kodediy/kode-dot/1-ECAD/cyberman/3-Assets/2-Images/5033981892.jpg

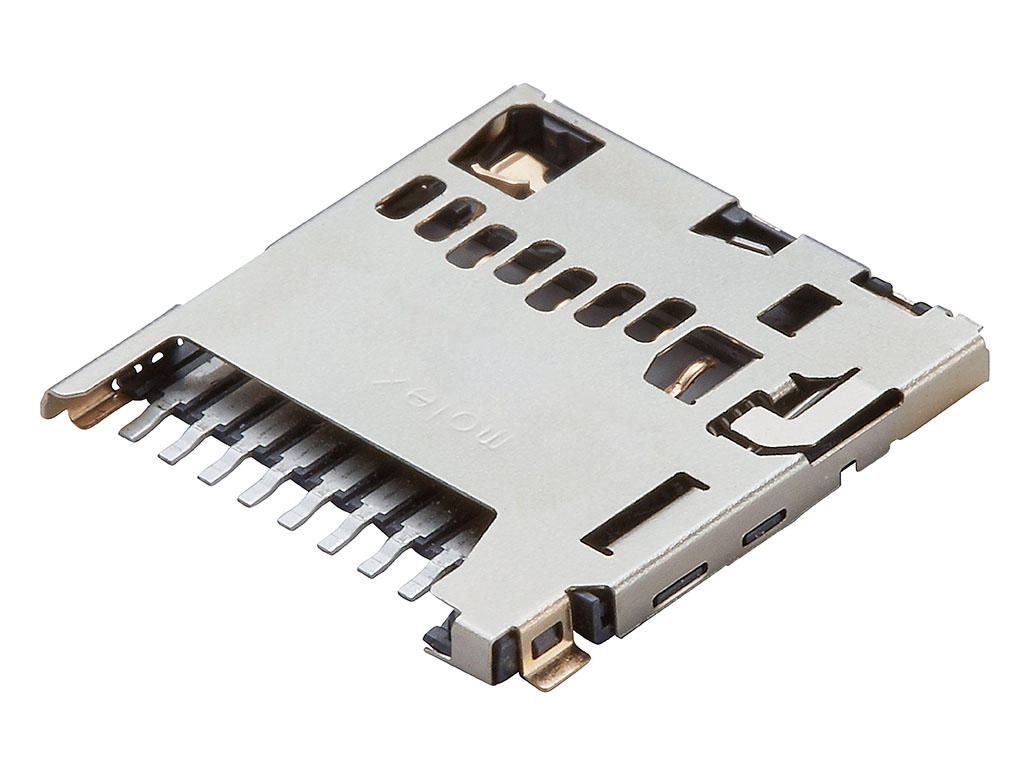
1-ECAD/cyberman/3-Assets/2-Images/5033981892.jpg
