kodediy/kode-dot/1-ECAD/cyberman/3-Assets/2-Images/532610271.jpeg

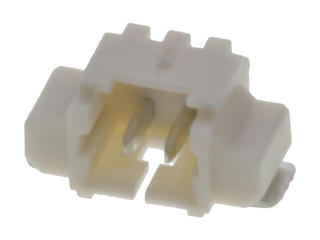
1-ECAD/cyberman/3-Assets/2-Images/532610271.jpeg
