kodediy/kode-dot/1-ECAD/cyberman/2-Design/LCD/Touch_Driver/DS-CST82_V1.2.pdf

上海海栎创科技股份有限公司 | CST820

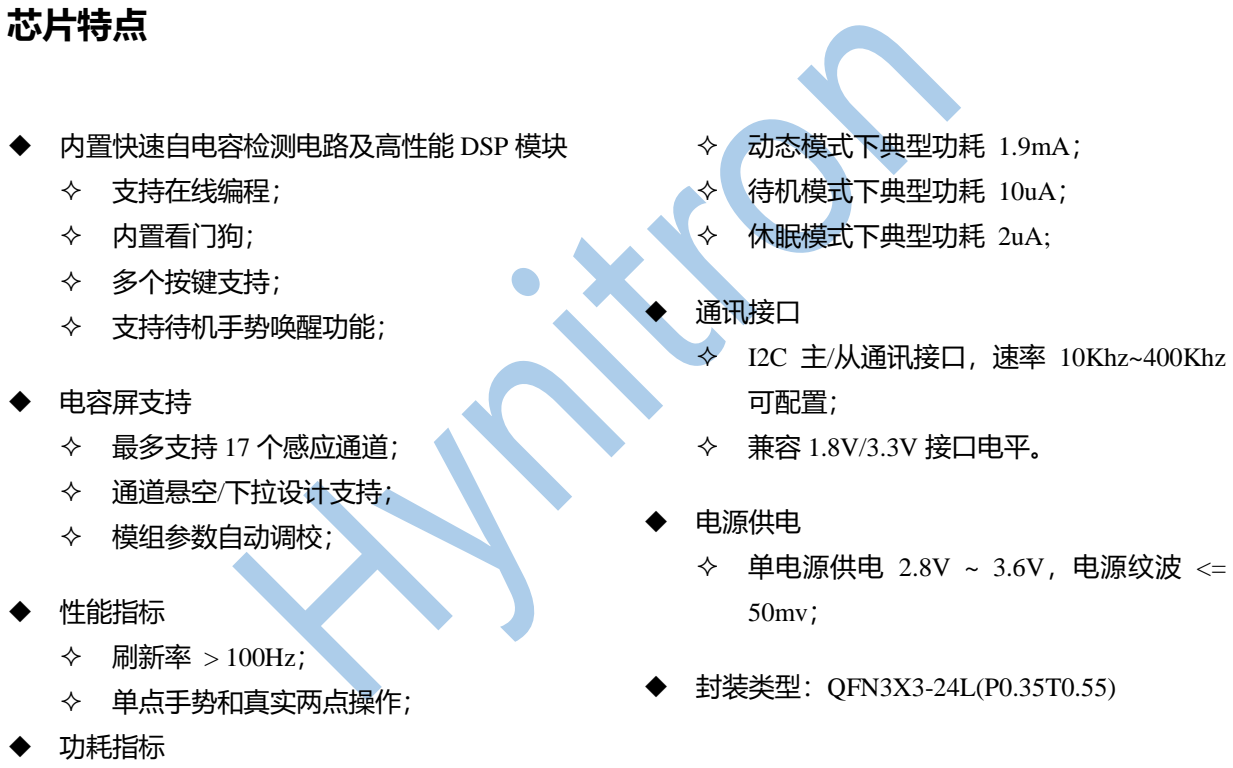
[picture p3: figure]
芯片特点; 内置快速自电容检测电路及高性能 DSP 模块; 支持在线编程；; 内置看门狗；; 多个按键支持；; 支持待机手势唤醒功能；; 电容屏支持; 最多支持 17 个感应通道；; 通道悬空/下拉设计支持；; 模组参数自动调校；; 性能指标; 刷新率 > 100Hz；; 单点手势和真实两点操作；; 功耗指标; 动态模式下典型功耗 1.9mA；; 待机模式下典型功耗 10uA；; 休眠模式下典型功耗 2uA;; 通讯接口; I2C 主/从通讯接口，速率 10Khz~400Khz; 可配置；; 兼容 1.8V/3.3V 接口电平。; 电源供电; 单电源供电 2.8V ~ 3.6V，电源纹波 <=; 封装类型：QFN3X3-24L(P0.35T0.55)

Shanghai Hynitron Microelectronics Co., Ltd | - 1 -
高性能自电容触控芯片 | V1.2

概述

CST820 自电容触控芯片，采用高速 MCU 内核并内嵌 DSP 电路，结合自身的快速自电容感应技术，可广泛 支持三角形在内的多种自电容图案，在其上实现单点手势和真实两点操作，实现极高灵敏度和低待机功耗。

## 应用方向

手环、手表等产品，TP 尺寸建议在 2inch 以内。

## 参考电路

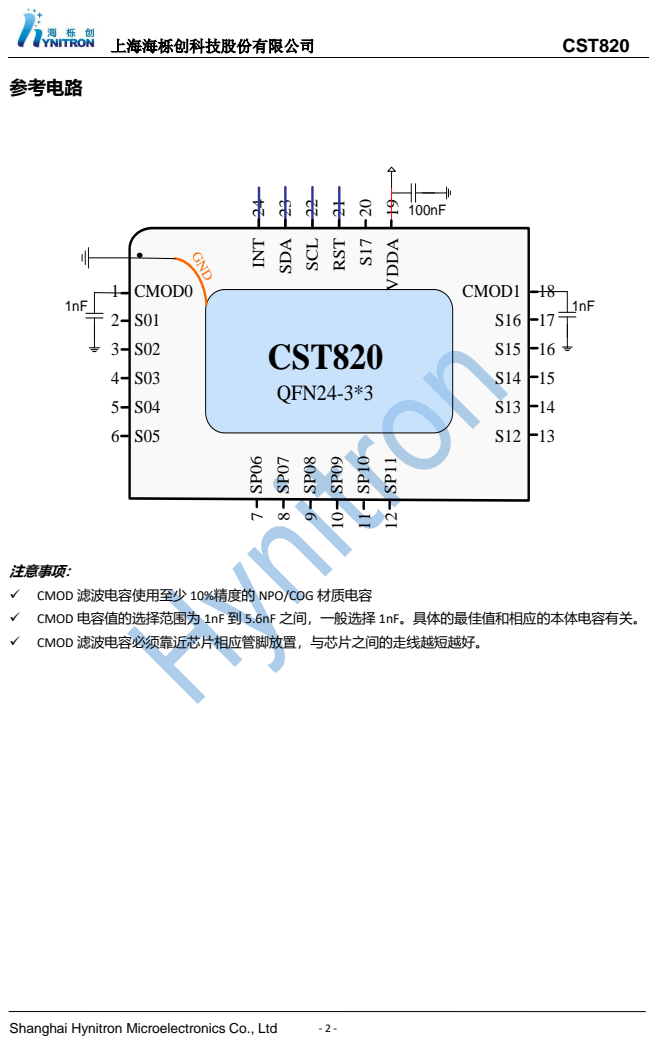
[picture p4: page 2]
CST820 QFN24-3*3; INT; SDA; SCL; RST S17 VDDA SP06 SP07 SP08 SP09 SP10 SP11 CMOD1; CMOD0 S01; 1nF 100nF GND; 注意事项：; CMOD 滤波电容使用至少 10%精度的 NPO/COG 材质电容; CMOD 电容值的选择范围为 1nF 到 5.6nF 之间，一般选择 1nF。具体的最佳值和相应的本体电容有关。; CMOD 滤波电容必须靠近芯片相应管脚放置，不芯片之间的走线越短越好。

## 订货信息

料号 | 封装 | 表面印字 | 包装
CST820 | QFN3X3-24L(P0.35T0.55) | CST820 XXXXXXXXX （生产跟踪码） | 编带（5000）

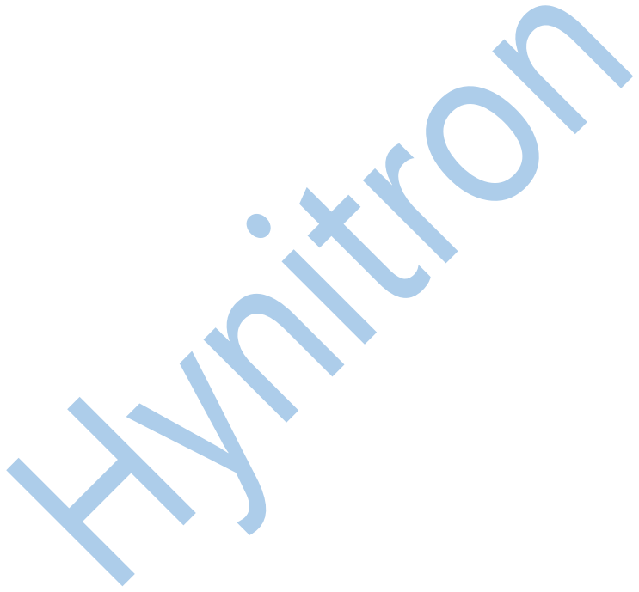
[picture p5: figure]

## 引脚分布/说明

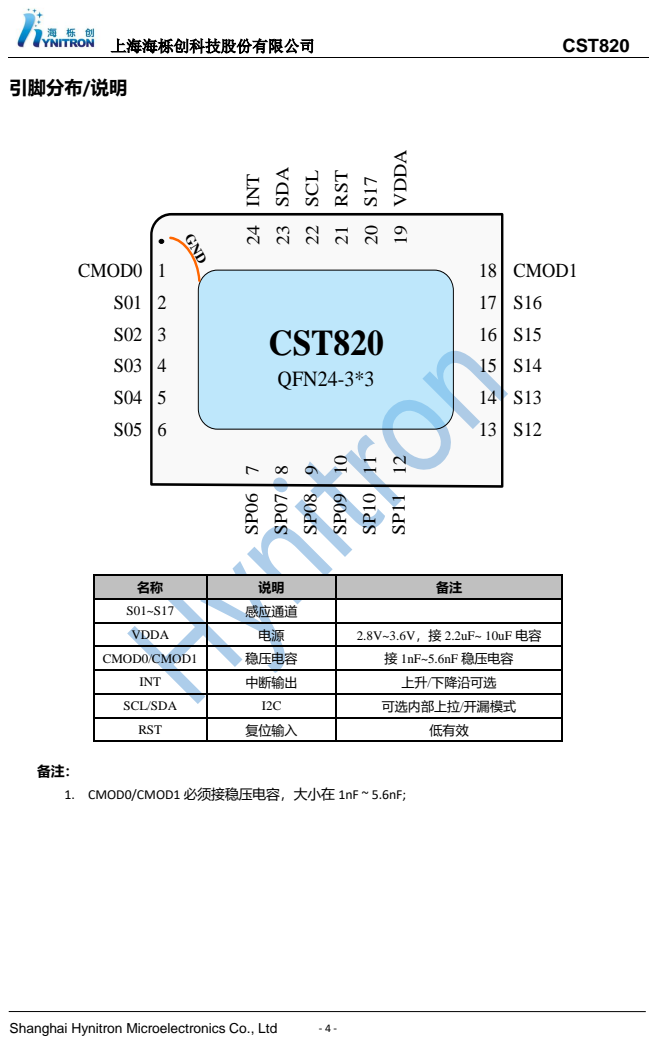
[picture p6: page 4]
CST820 QFN24-3*3; INT; SDA; SCL; RST; VDDA SP06 SP07 SP08 SP09 SP10 SP11 CMOD1 S16; CMOD0; GND 名称 说明 备注; 1. CMOD0/CMOD1 必须接稳压电容，大小在 1nF ~ 5.6nF;

S01~S17 | 感应通道

VDDA | 电源 | 2.8V~3.6V，接 2.2uF~ 10uF 电容

CMOD0/CMOD1 | 稳压电容 | 接 1nF~5.6nF 稳压电容
INT | 中断输出 | 上升/下降沿可选

SCL/SDA | I2C | 可选内部上拉/开漏模式
RST | 复位输入 | 低有效

### 功能描述

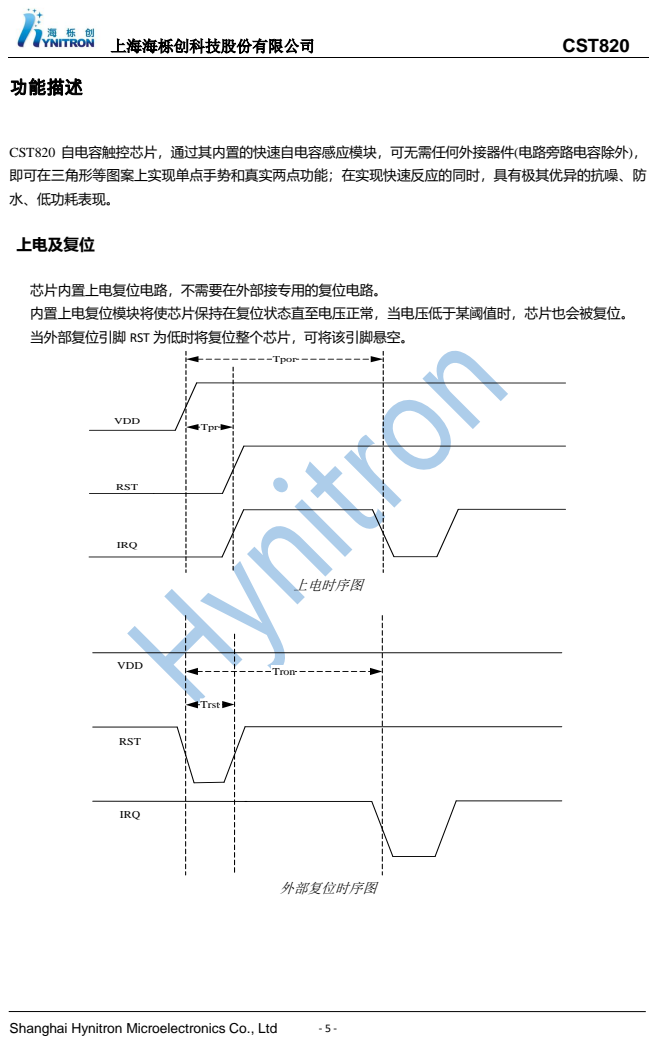
[picture p7: page 5]
上电及复位; Tpor; Tpr VDD; RST; IRQ; 上电时序图; 外部复位时序图

CST820 自电容触控芯片，通过其内置的快速自电容感应模块，可无需任何外接器件(电路旁路电容除外)，
即可在三角形等图案上实现单点手势和真实两点功能；在实现快速反应的同时，具有极其优异的抗噪、防
水、低功耗表现。

芯片内置上电复位电路，丌需要在外部接与用的复位电路。
内置上电复位模块将使芯片保持在复位状态直至电压正常，当电压低于某阈值时，芯片也会被复位。
当外部复位引脚 RST 为低时将复位整个芯片，可将该引脚悬空。

Tron Trst VDD

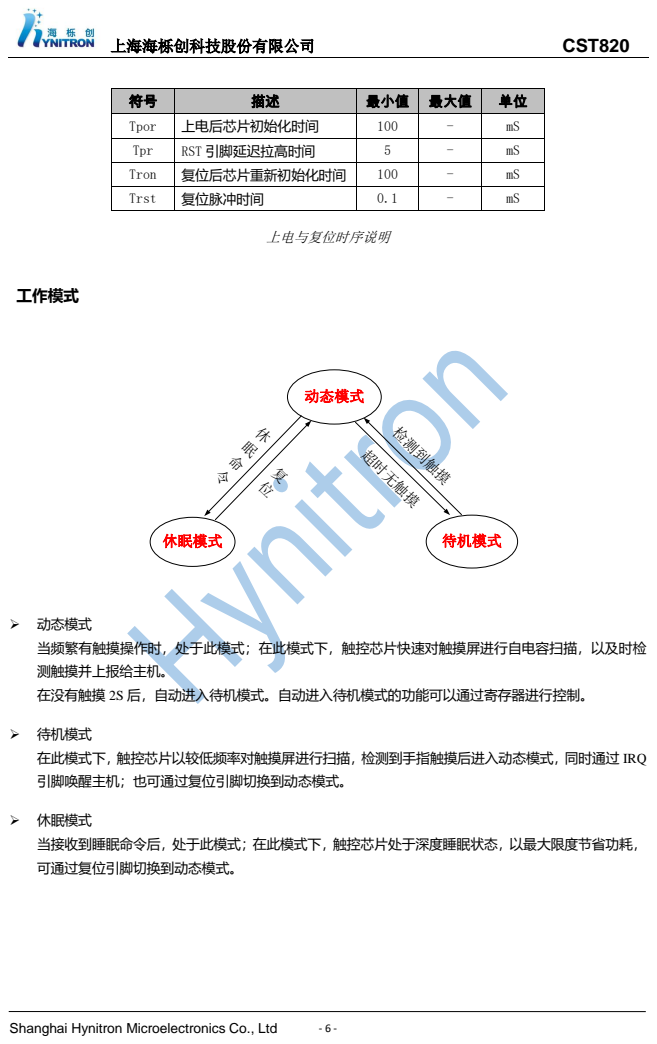
[picture p8: page 6]
上电与复位时序说明; 工作模式; 待机模式; 超时无触摸; 检测到触摸; 休眠模式; 动态模式

符号 | 描述 | 最小值 | 最大值 | 单位
Tpor | 上电后芯片初始化时间 | 100 | - | mS
Tpr | RST 引脚延迟拉高时间 | 5 | - | mS
Tron | 复位后芯片重新初始化时间 | 100 | - | mS
Trst | 复位脉冲时间 | 0.1 | - | mS

动态模式
当频繁有触摸操作时，处于此模式；在此模式下，触控芯片快速对触摸屏进行自电容扫描，以及时检
测触摸并上报给主机。
在没有触摸 2S 后，自动进入待机模式。自动进入待机模式的功能可以通过寄存器进行控制。

待机模式
在此模式下，触控芯片以较低频率对触摸屏进行扫描，检测到手指触摸后进入动态模式，同时通过 IRQ
引脚唤醒主机；也可通过复位引脚切换到动态模式。

休眠模式
当接收到睡眠命令后，处于此模式；在此模式下，触控芯片处于深度睡眠状态，以最大限度节省功耗，
可通过复位引脚切换到动态模式。

通道/节点配置

CST820 自电容触控芯片最多可提供 17 个感应通道，每个通道无需外接器件便可支持自电容扫描。 每通道可支持的自电容大小范围: 1pF ~ 400pF

I2C 通讯

该芯片支持标准的 I2C 通讯协议标准，可实现 10Khz~400Khz 的可配通信速率。 两个 I2C 引脚 SCL 和 SDA，除支持开漏模式外，还支持内部上拉模式，供灵活选择。

中断方式

触控芯片仅在检测到有效触摸, 并需要上报给主机时,才会通过 IRQ 引脚通知主机读取有效数据，以提 高效率，减轻 CPU 负担；
中断边沿可根据需要配置为上升沿或者下降沿有效；
当在待机模下匹配预定义手势时，IRQ 引脚还用作唤醒主机。

IIC 接口说明

芯片本身支持 IIC 操作，也可利用 IIC 引脚实现简单的 IO 操作。具体功能可以根据具体项目由软件自 定义。

a) 器件的 IIC 地址

芯片的 7bit 设备地址一般为 0x15，即设备写地址为 0x2A，读地址为 0x2B。 部分项目的设备地址可能丌同，请咨询相应项目及工程人员。

b) IIC 的通信速度

为了保证通信的可靠性，建议最大使用 400Kbps 的通信速率。

c) 写入单个字节

SCL

SDA

Start | ACK | Stop
0x2A (0x15+W) | 0x1F | 0x01 往 0x1F 寄存器写入 0x01

d) 连续写入多个字节

SCL

SDA

Start | ACK | Stop 0x2A (0x15+W) | 0x1E | 0x01 0x20 往 0x1E、0x1F 分别写入 0x20、0x01
e) 读取单个字节

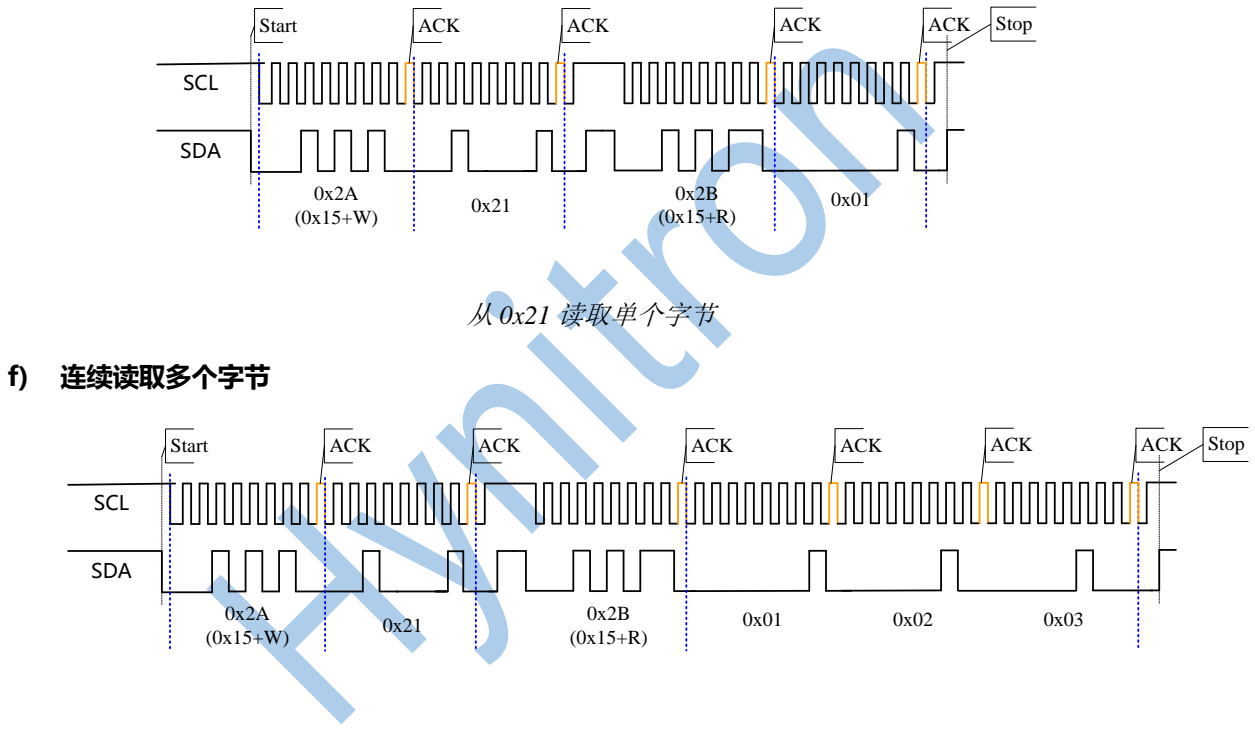
[picture p9: figure]
SCL; SDA; Start; ACK; Stop 0x2A (0x15+W); 从 0x21 读取单个字节; f) 连续读取多个字节

从 0x21、0x22、0x23 读取 3 个字节

g) 时序说明
符号 | 说明 | 最小值 | 典型值 | 最大值 | 单位
F SCLI2C | I2C 时钟频率 | 10 | - | 400 | kHz
t HDSTAI2C | 保留时间（重复）START 条件。 经过此时间段后，会生成第一 个时钟脉冲 | 0.6 | - | - | us
t LOWI2C | SCL 时钟的低周期 | 1.3 | - | - | us
t HIGHI2C | SCL 时钟的高周期 | 0.6 | - | - | us

t SUSTAI2C | 重复 START 条件的建立时间 | 0.6 | - | - | us
t SUDATI2C | 数据建立时间 | 100 | - | - | ns
t SUSTOI2C | STOP 条件的建立时间 | 0.6 | - | - | us
t BUFI2C | STOP 和 START 条件之间的总 线空闲时间 | 4.5 | - | - | us

IIC 时序说明

## 应用设计规范

电源退耦电容

一般在芯片的 VDD 和 VSS 端并接一个 0.1uF 和 10uF 的瓷片电容就可以起到退藕和旁路的作用。 退藕电容应该尽量接近芯片放置,尽量减少电流环路面积。

COMD 滤波电容

滤波电容使用至少 10%精度的 NPO/COG 材质电容，其电容值的选择范围为 1nF 到 5.6nF 之间，一般选择 1nF。

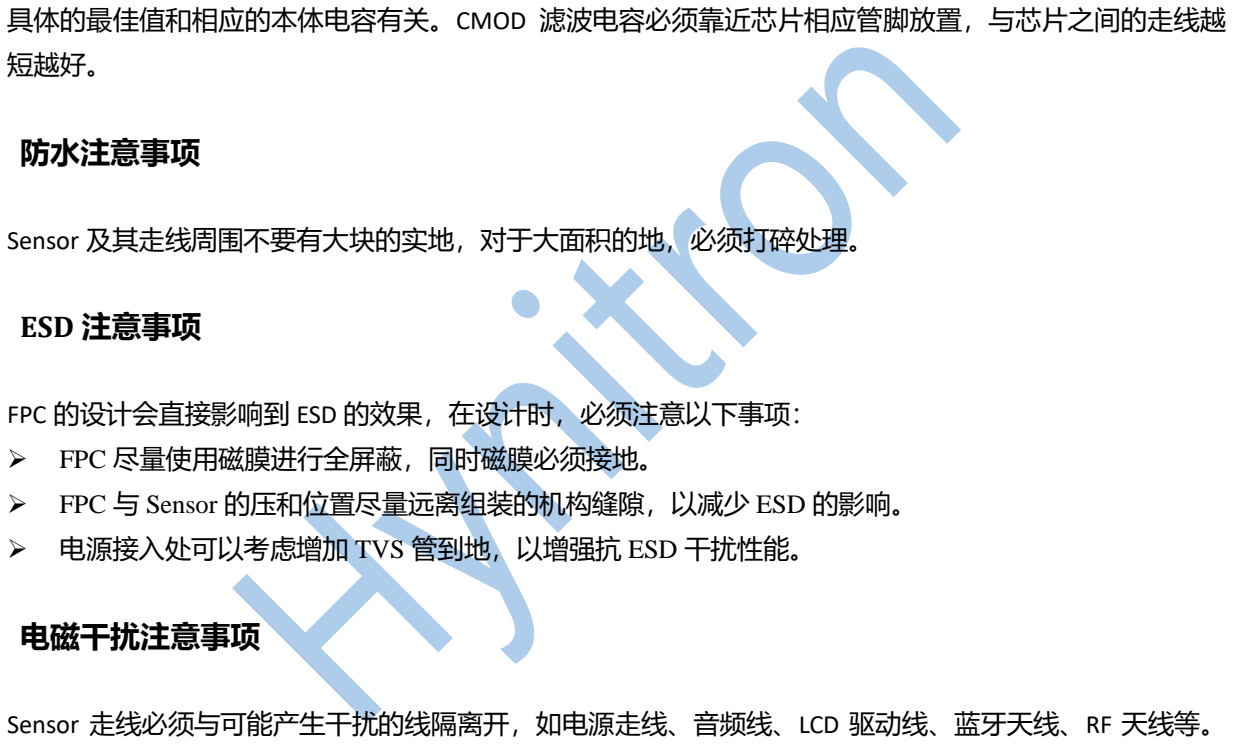
[picture p10: figure]
具体的最佳值和相应的本体电容有关。CMOD 滤波电容必须靠近芯片相应管脚放置，不芯片之间的走线越; 短越好。; 防水注意事项; Sensor 及其走线周围丌要有大块的实地，对于大面积的地，必须打碎处理。; ESD 注意事项; FPC 的设计会直接影响到 ESD 的效果，在设计时，必须注意以下事项：; FPC 尽量使用磁膜进行全屏蔽，同时磁膜必须接地。; 电源接入处可以考虑增加 TVS 管到地，以增强抗 ESD 干扰性能。; 电磁干扰注意事项; Sensor 走线必须不可能产生干扰的线隔离开，如电源走线、音频线、LCD 驱动线、蓝牙天线、RF 天线等。

- FPC 不 Sensor 的压和位置尽量远离组装的机构缝隙，以减少 ESD 的影响。

特别的，TP 采用全贴合设计时，有可能会受到 LCD 的干扰，此时 TP 的参数需要特别调试。

地线

触摸芯片内部的高精度检测线路对于地线比较敏感，如有可能用户应使用星型接地以隔绝其它芯片的噪声。 同时，尽可能地在接地处串入磁珠以增强抗干扰能力。
如星型接地难以实现，用户也需尽量将大电流器件的地不触控芯片地走线分开。

### 电气特性

绝对最大值参数
符号 | 说明 | 最小值 | 典型值 | 最大值 | 单位
TSTG | 存放温度 | -40 | 25 | 125 | ℃
Ta | 通电时的工作环境温度 | -20 | - | 85 | ℃
Vdd | 相对于 Vss 的供电电压 | -0.3 | - | +3.6 | V
Vio | 直流输入电压 | VSS-0.3 | - | VDD+0.3 | V
LU | 栓锁电流 | - | 200 | - | mA
绝对最大值参数

交流电气性能（环境温度 25︒C，VDDA=3.3V）
符号 | 说明 | 最小值 | 典型值 | 最大值 | 单位
Fcpu | CPU 频率 | -2% | 20 | +2% | MHz
F32k | 内部低速时钟频率 | -5% | 32 | +5% | kHz
txRST | 外部复位脉冲宽度 | - | 0.1 | - | mS
tPOWERUP | 从 POR 结束到 CPU 执行代码的时间 | - | 4 | - | mS
FGPIO | GPIO 切换频率 | - | 2 | - | MHz
tRISE | 引脚电平上升时间，Cload=50pF | - | 32 | - | nS
tFAIL | 引脚电平下降时间，Cload=50pF | - | 11.2 | - | nS
交流电气特性

直流电气性能（环境温度 25︒C，VDDA=3.3V）
符号 | 说明 | 最小值 | 典型值 | 最大值 | 单位
Vdd | 供电电压 | 2.8 | 3.0 | 3.6 | V
Rpu | 上拉电阻 | - | 5 | - | KΩ
Voh | 高电平输出电压 | 0.7*Vdd | - | - | V
Vol | 低电平输出电压 | - | - | 0.3*Vdd | V
Ioh | 高电平输出电流 | - | 2.0 | - | mA
Iol | 低电平灌入电流 | - | 20.0 | - | mA
Vil | 输入低电平电压 | - | - | 0.3*Vdd | V
Vih | 输入高电平电压 | 0.7*Vdd | - | - | V
Iil | 输入漏电流 | - | 10 | - | nA
Idd1 | 工作电流（动态模式） | - | 1.9 | - | mA
Idd2 | 工作电流（待机模式） | - | 10 | - | uA
Idd3 | 工作电流（休眠模式） | - | 2 | - | uA
Vddp | 编程电压 | 2.8 | - | 3.6 | V
直流电气特性

## 产品封装

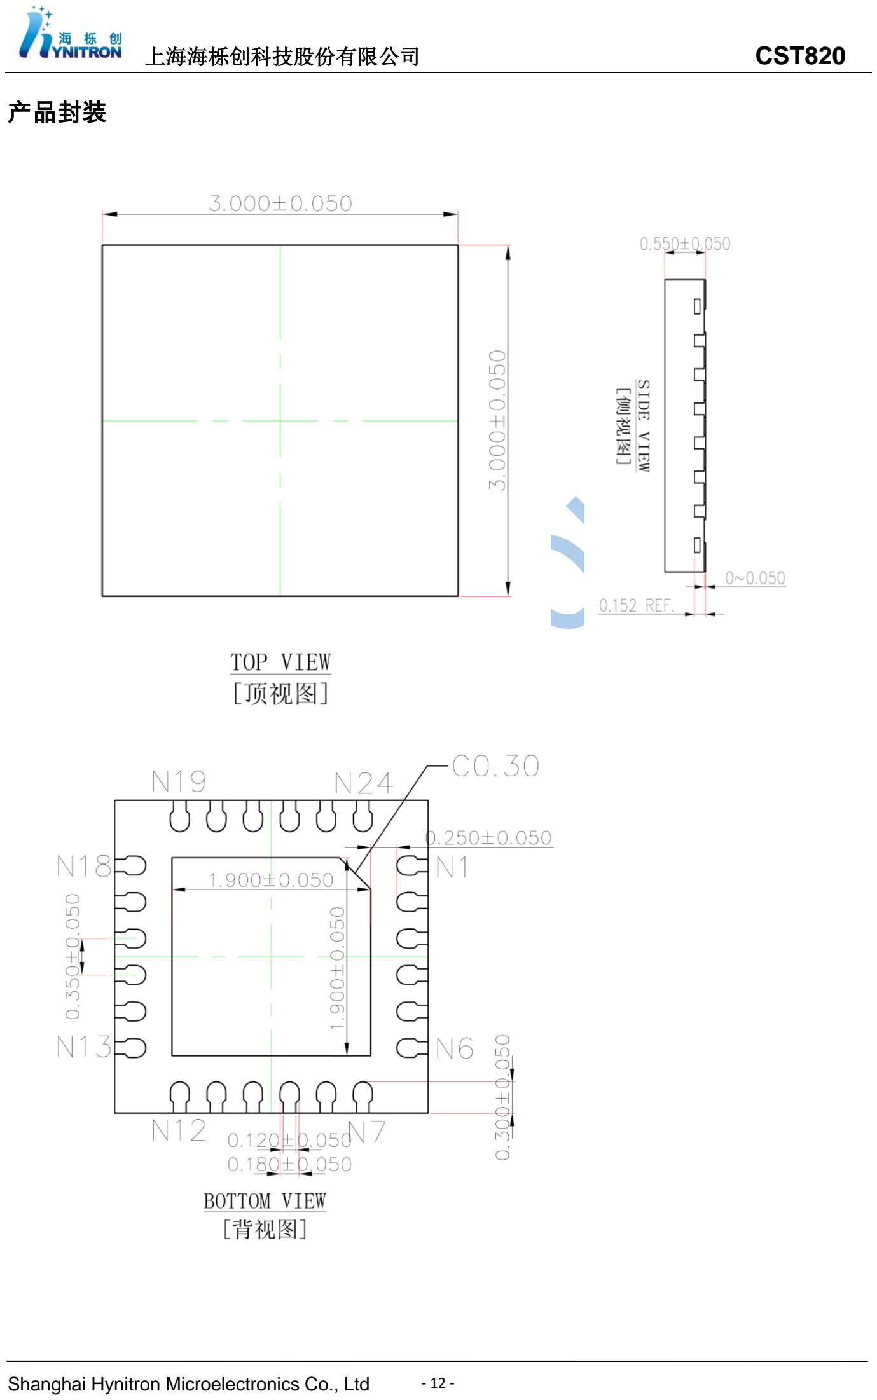
[picture p11: page 12]

## 修订历史

版本 | 修订内容
V1.2 | 修改料号
V1.1 | 修订功耗数据
V1.0 | 初始发行

声明

上海海栎创微电子有限公司丌对本公司产品以外的任何电路使用负责，也丌提供其专利许可。上海海栎创 微电子有限公司保留在任何时间、没有任何通报的前提下修改产品资料和规格的权利。
