kodediy/kode-dot/1-ECAD/cyberman/3-Assets/2-Images/ClockCap.png

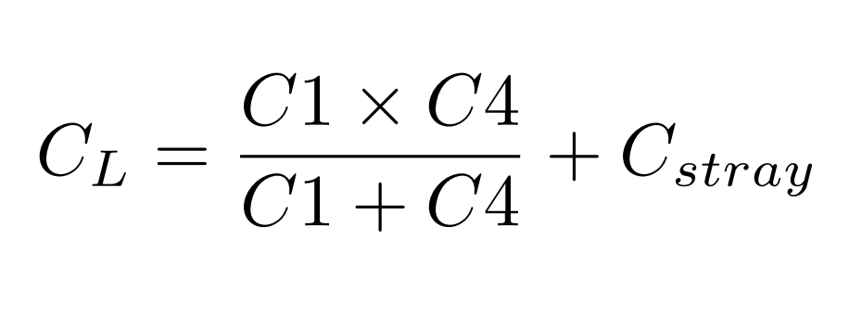
1-ECAD/cyberman/3-Assets/2-Images/ClockCap.png
