kodediy/kode-dot/1-ECAD/cyberman/3-Assets/2-Images/default-configuration-strapping-pins.png

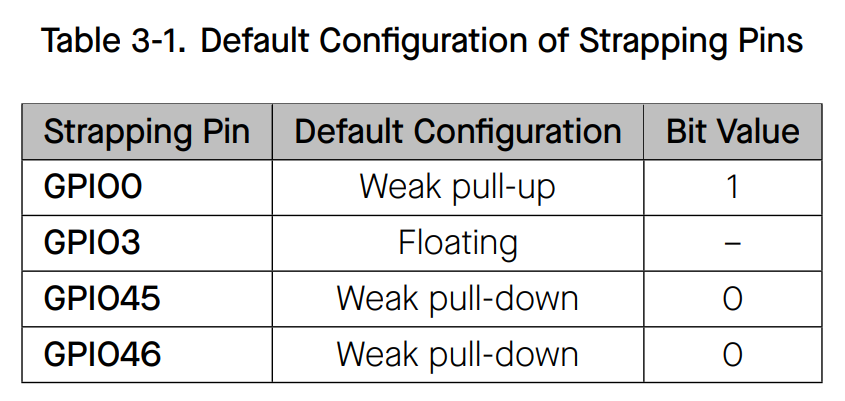
1-ECAD/cyberman/3-Assets/2-Images/default-configuration-strapping-pins.png
