kodediy/kode-dot/1-ECAD/cyberman/3-Assets/2-Images/pin-to-pin-Map.png

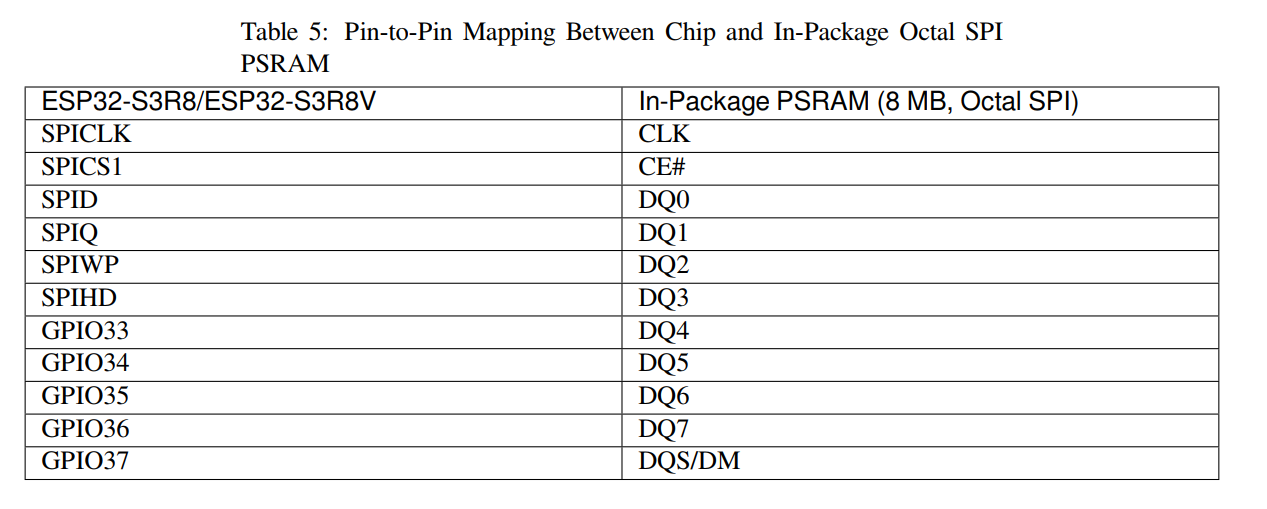
1-ECAD/cyberman/3-Assets/2-Images/pin-to-pin-Map.png
