kodediy/kode-dot/1-ECAD/cyberman/3-Assets/2-Images/Power-up&Reset_Timing.png

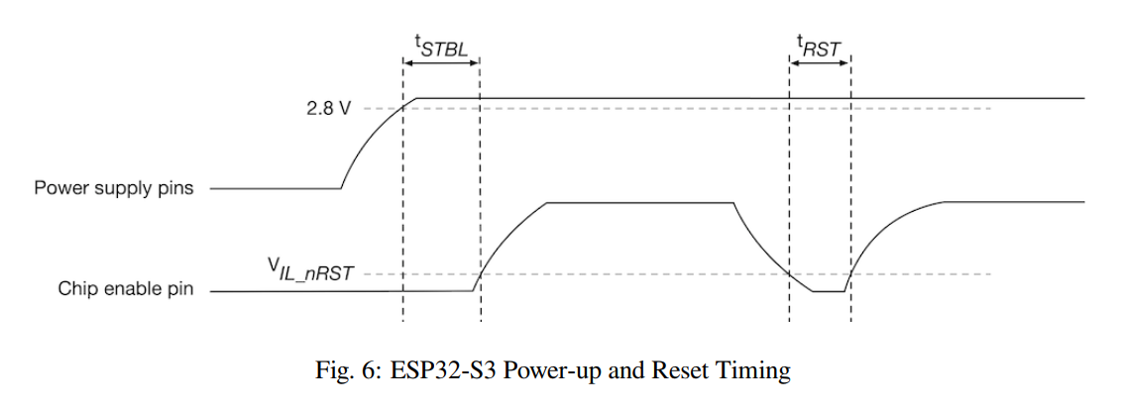
1-ECAD/cyberman/3-Assets/2-Images/Power-up&Reset_Timing.png
