kodediy/kode-dot/1-ECAD/cyberman/3-Assets/2-Images/S3B-ZR-SM4A-TF.jpg

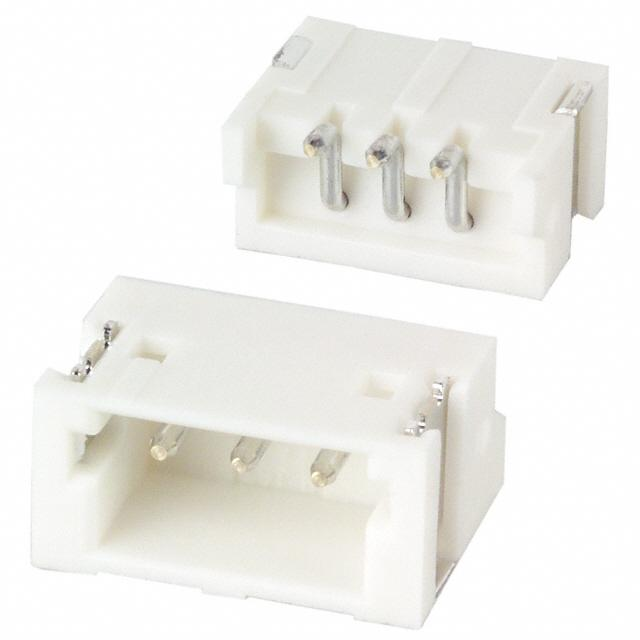
1-ECAD/cyberman/3-Assets/2-Images/S3B-ZR-SM4A-TF.jpg
