kodediy/kode-dot/1-ECAD/cyberman/3-Assets/2-Images/VDD_SPI_Voltage_Control.png

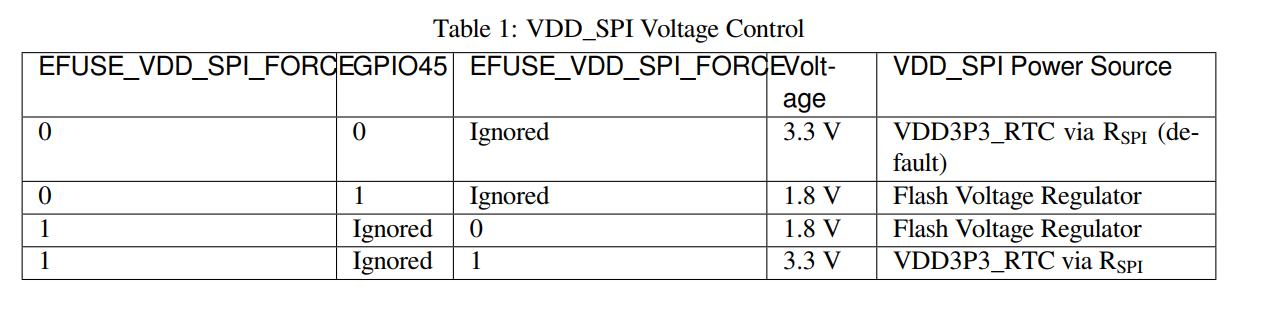
1-ECAD/cyberman/3-Assets/2-Images/VDD_SPI_Voltage_Control.png
