kodediy/kode-dot/1-ECAD/cyberman/3-Assets/2-Images/YXT-BB10-24S-02.jpg

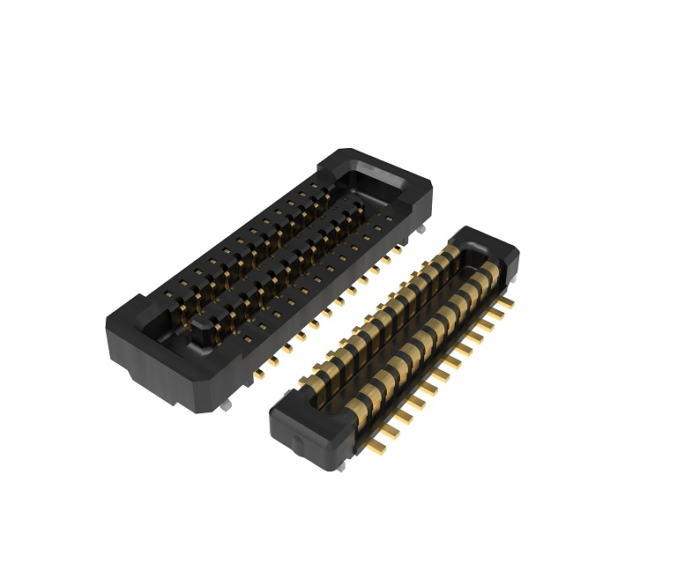
1-ECAD/cyberman/3-Assets/2-Images/YXT-BB10-24S-02.jpg
