kodediy/kode-dot/1-ECAD/cyberman/2-Design/LCD/WD206F024-A Pin specification/WD206F024-A Pin specification.xlsx

NO. | Pin Name | I/O | Description
1 | CS | CO5300 | Chip select input pin (“Low” enable) SPI I/F.
2 | QSPI-IO0 |  | Serial Data Input in QSPI,data Lane 0.
3 | QSPI-IO1 |  | Serial Data Input in QSPI,data Lane 1.
4 | QSPI-CLK |  | SCL: A synchronous clock signal in SPI I/F.
5 | QSPI-IO3 |  | Serial Data Input in QSPI,data Lane 3.
6 | QSPI-IO2 |  | Serial Data Input in QSPI,data Lane 2.
7 | NC |  | NC
8 | NC |  | NC
9 | RST |  | AMOLED Reset signal Input
10 | NC |  | NC
11 | NC-MTP |  | NC
12 | NC |  | NC
13 | GND |  | Ground Terminal
14 | TE |  | Tearing Effect
15 | VCC |  | Driver IC(Touch + Display) Digital I/O Power Supply 3.3V
16 | VCI-EN |  | Analog Voltage for Display Driver 3.3V
17 | VBAT |  | Battery Voltage 3.7V TYP. 3.7V
18 | GND |  | Ground Terminal
19 | TP-SCL | CST820 | Touch Panel Clock Input. Communication Voltage follow IOVCC If not used, please open this pin.
20 | TP-SDA |  | Touch Panel Data Input and output. Communication Voltage follow IOVCC If not used, , please open this pin.
21 | TP-RST |  | TP Reset signal Input. Communication Voltage follow IOVCC If not used, , please open this pin.
22 | TP-INT |  | Touch Panel Interrupt Output. If not used, please open this pin.
23 | TP-VDD |  | Analog Voltage for TP Driver (3.3V)
24 | GND |  | Ground Terminal
