kodediy/kode-dot/1-ECAD/cyberman/4-Library/3-3DModels/LQM2MPNR47MGHL.stp

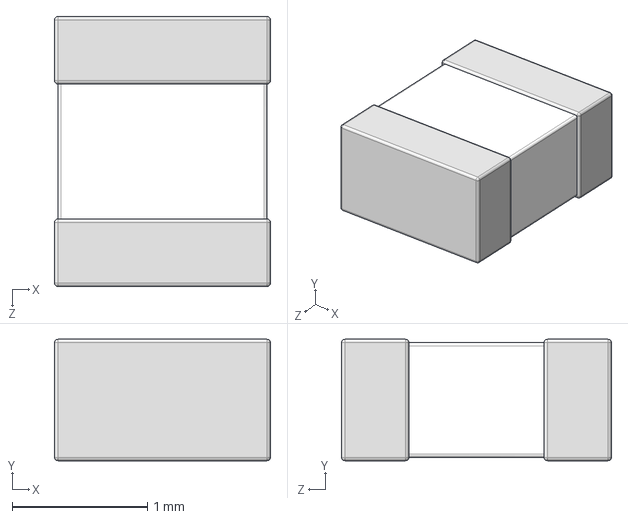
[picture p20: CAD file, 2024-12-18]
1-ECAD/cyberman/4-Library/3-3DModels/LQM2MPNR47MGHL.stp
1.60 x 0.9 x 2.00 mm
