kodediy/kode-dot/1-ECAD/cyberman/4-Library/3-3DModels/MLP2012HR47MT0S1.stp

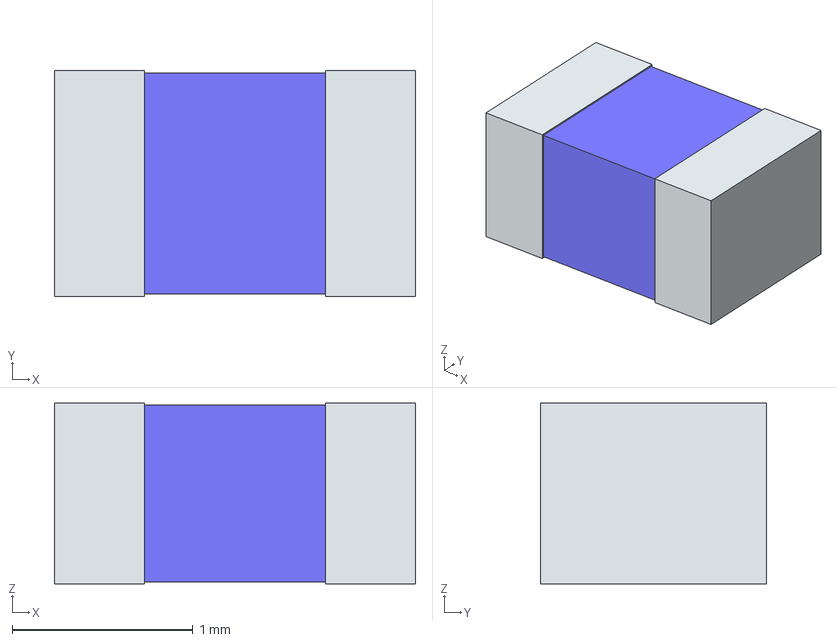
[picture p21: CAD file, 2024-12-18]
1-ECAD/cyberman/4-Library/3-3DModels/MLP2012HR47MT0S1.stp
2.00 x 1.25 x 1.00 mm
term1
term2
