kodediy/kode-dot/1-ECAD/cyberman/4-Library/3-3DModels/DMN313DLT-7.stp

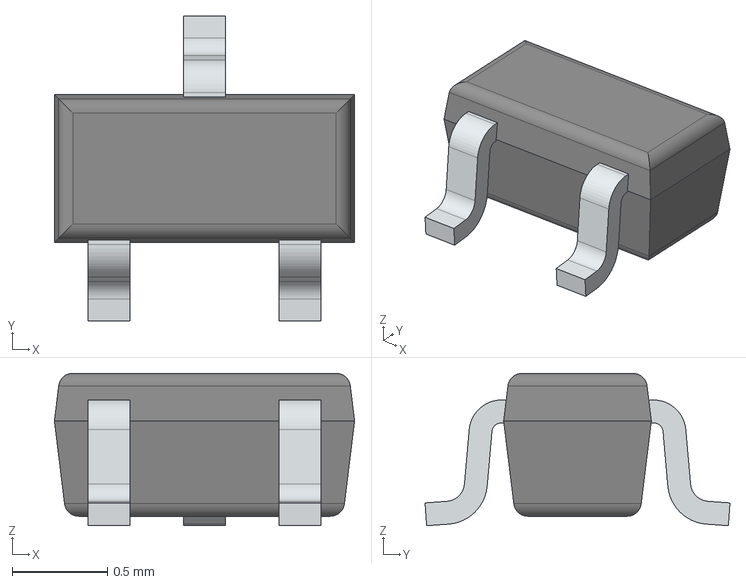
[picture p22: CAD file, 2024-12-17]
1-ECAD/cyberman/4-Library/3-3DModels/DMN313DLT-7.stp
1.58 x 1.60 x 0.799 mm
LF
CPD
