kodediy/kode-dot/1-ECAD/cyberman/4-Library/3-3DModels/S3B-ZR-SM4A-TF.STEP

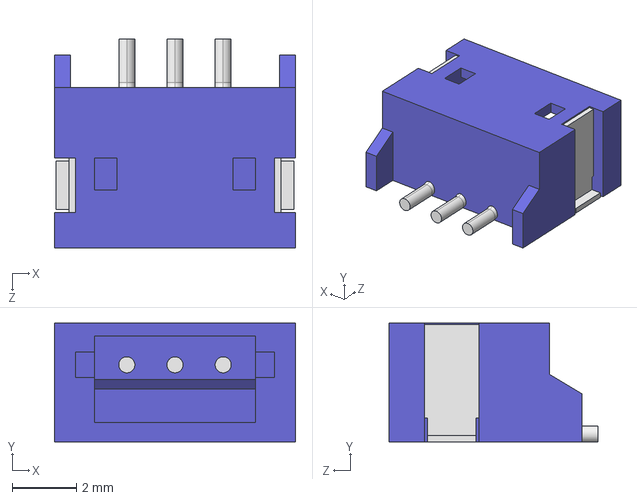
[picture p23: CAD file, 2024-12-17]
1-ECAD/cyberman/4-Library/3-3DModels/S3B-ZR-SM4A-TF.STEP
7.50 x 3.70 x 6.50 mm
