kodediy/kode-dot/1-ECAD/cyberman/4-Library/3-3DModels/ERBRD2R00X.stp

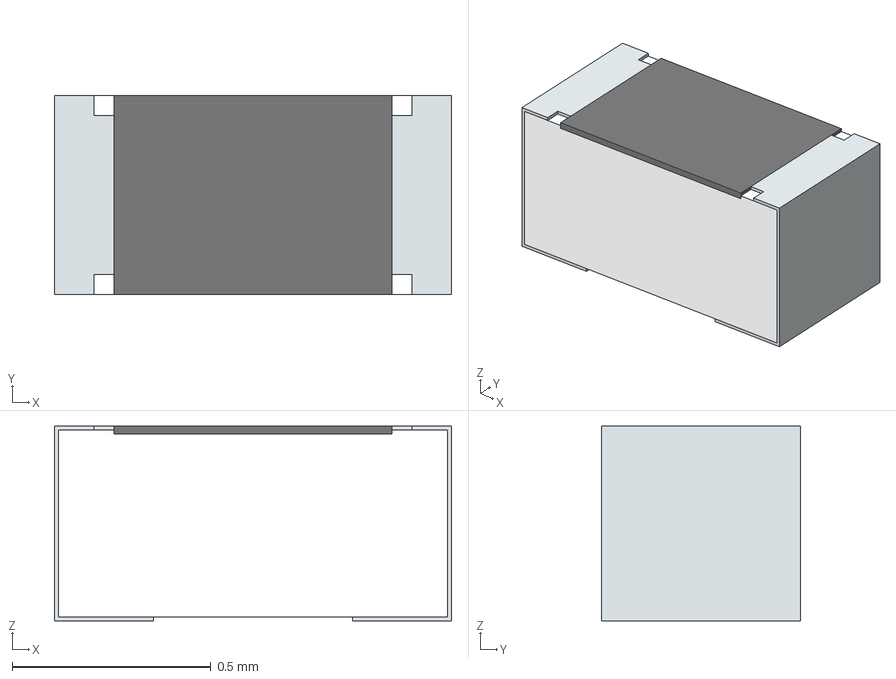
[picture p24: CAD file, 2024-12-14]
1-ECAD/cyberman/4-Library/3-3DModels/ERBRD2R00X.stp
1.00 x 0.5 x 0.49 mm
solidBody
Terminal
solidLid
