kodediy/kode-dot/1-ECAD/cyberman/4-Library/3-3DModels/LESD5D5.0CT1G.stp

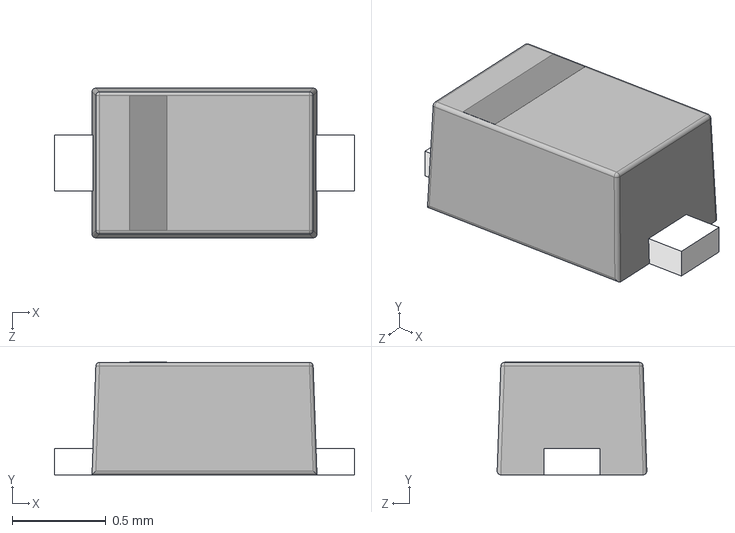
[picture p25: CAD file, 2024-12-11]
1-ECAD/cyberman/4-Library/3-3DModels/LESD5D5.0CT1G.stp
1.60 x 0.601 x 0.799 mm
