kodediy/kode-dot/1-ECAD/cyberman/4-Library/3-3DModels/LESD8D3.3CAT5G.stp

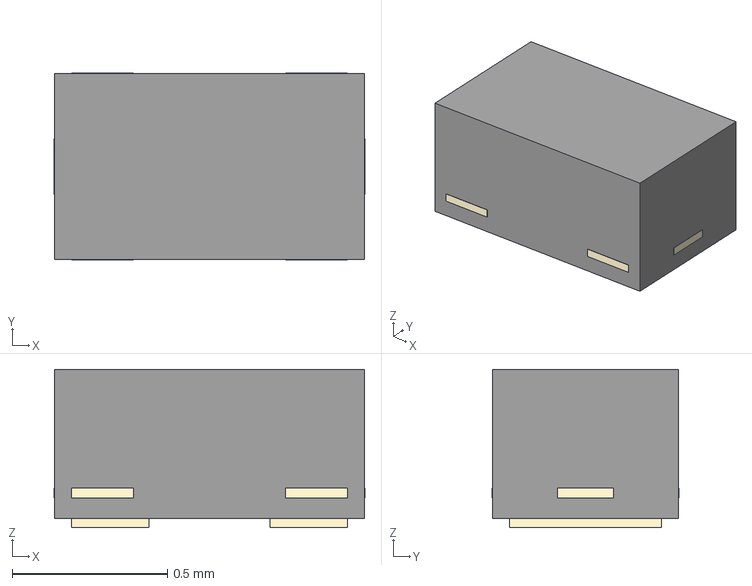
[picture p26: CAD file, 2024-12-11]
1-ECAD/cyberman/4-Library/3-3DModels/LESD8D3.3CAT5G.stp
1.00 x 0.602 x 0.51 mm
