kodediy/kode-dot/1-ECAD/cyberman/4-Library/3-3DModels/SKRMAAE010.STEP

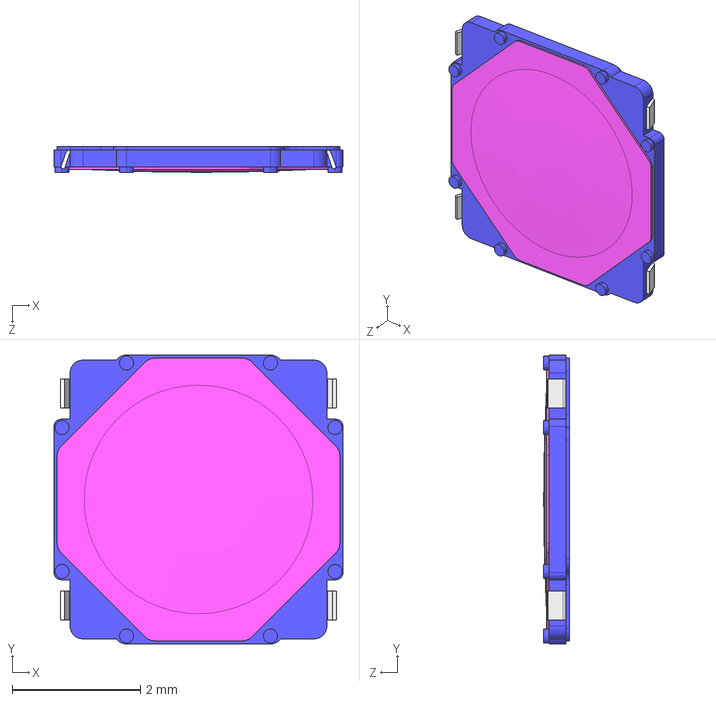
[picture p27: CAD file, 2024-12-10]
1-ECAD/cyberman/4-Library/3-3DModels/SKRMAAE010.STEP
4.50 x 4.50 x 0.4 mm
