kodediy/kode-dot/1-ECAD/cyberman/4-Library/3-3DModels/0402_capacitor.stp

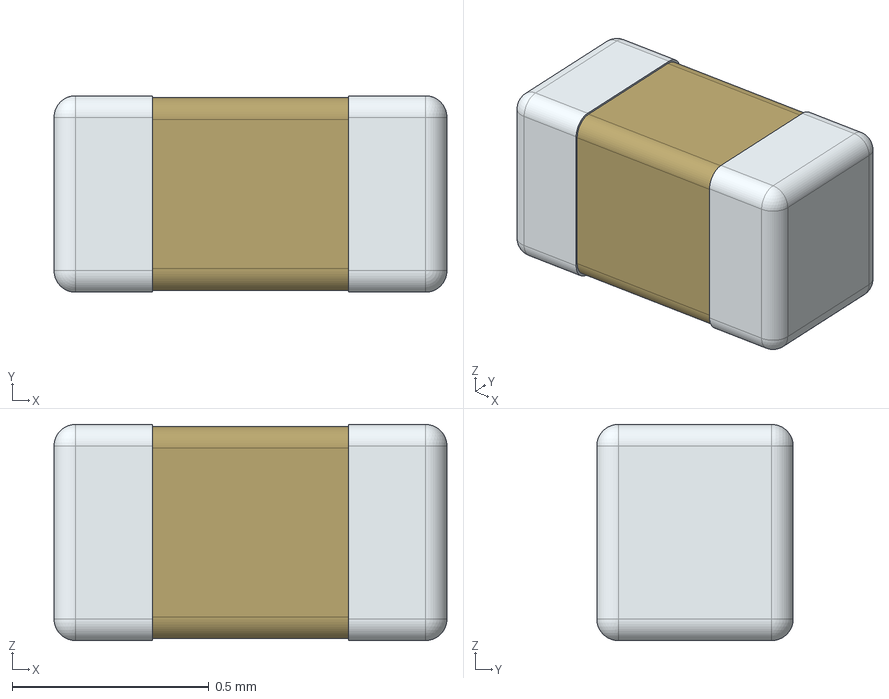
[picture p28: CAD file, 2024-12-10]
1-ECAD/cyberman/4-Library/3-3DModels/0402_capacitor.stp
1.00 x 0.5 x 0.55 mm
