kodediy/kode-dot/1-ECAD/cyberman/4-Library/3-3DModels/0402_resistor.stp

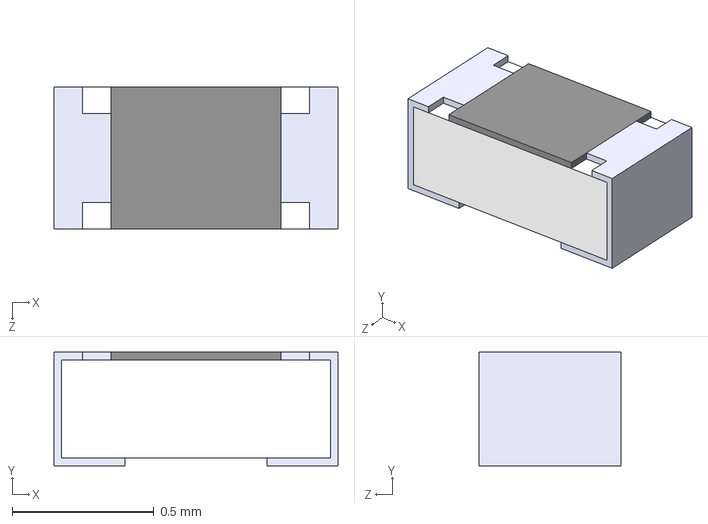
[picture p29: CAD file, 2024-12-10]
1-ECAD/cyberman/4-Library/3-3DModels/0402_resistor.stp
1.00 x 0.4 x 0.5 mm
