kodediy/kode-dot/1-ECAD/cyberman/4-Library/3-3DModels/0402_inductor.stp

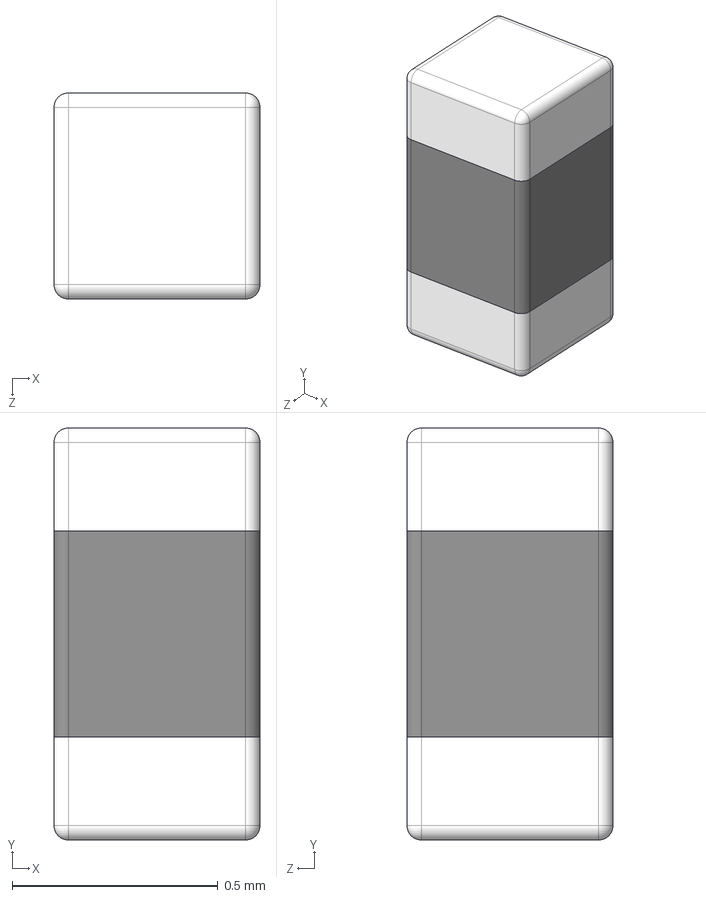
[picture p30: CAD file, 2024-12-09]
1-ECAD/cyberman/4-Library/3-3DModels/0402_inductor.stp
0.5 x 1.00 x 0.5 mm
