kodediy/kode-dot/1-ECAD/cyberman/4-Library/3-3DModels/PM254-2-10-W-8.5.step

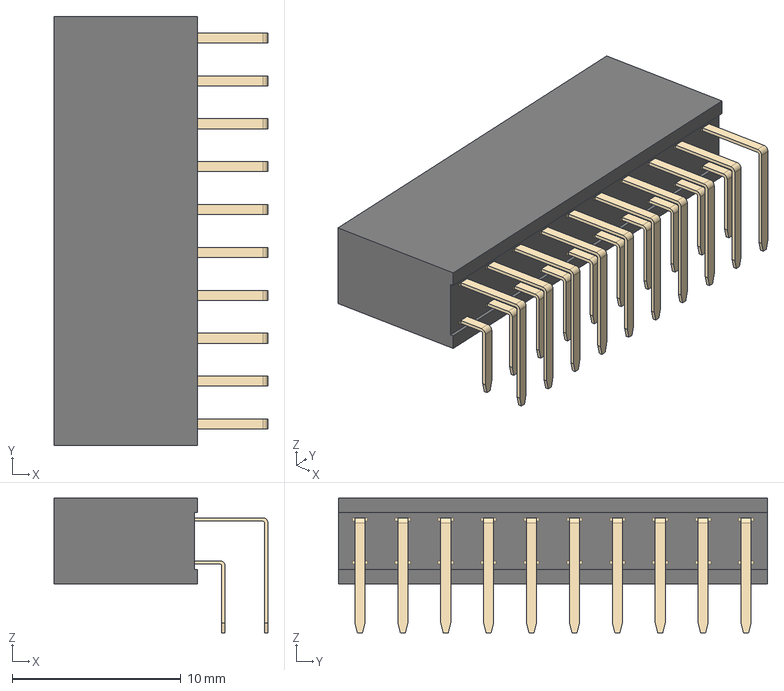
[picture p31: CAD file, 2024-12-09]
1-ECAD/cyberman/4-Library/3-3DModels/PM254-2-10-W-8.5.step
12.7 x 25.4 x 7.98 mm
