kodediy/kode-dot/1-ECAD/cyberman/4-Library/3-3DModels/RS3221-3.3YF3.stp

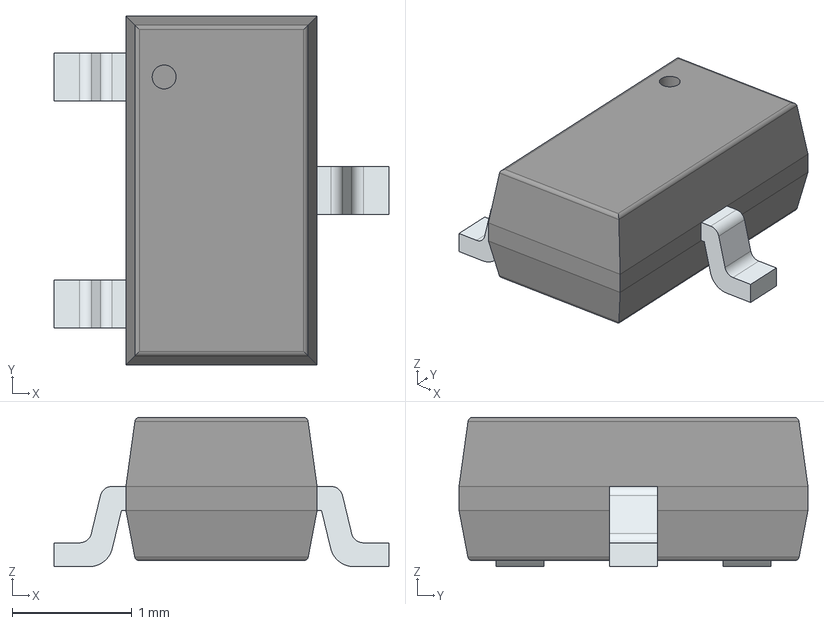
[picture p32: CAD file, 2024-12-05]
1-ECAD/cyberman/4-Library/3-3DModels/RS3221-3.3YF3.stp
2.80 x 2.92 x 1.25 mm
PinsArrayL
FilletPinR
