kodediy/kode-dot/1-ECAD/cyberman/4-Library/3-3DModels/ICS-43434.stp

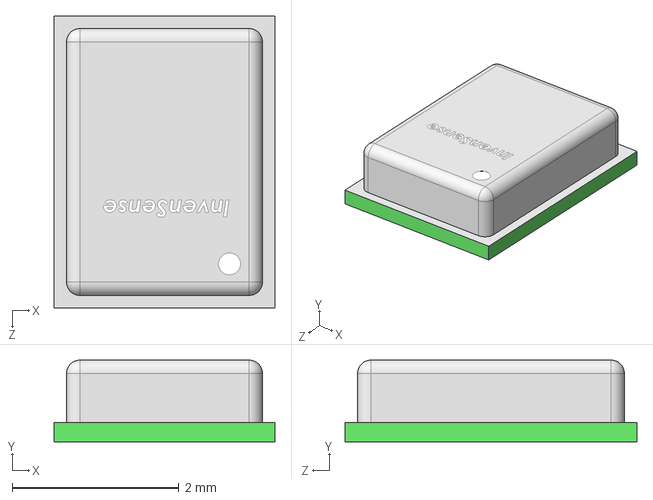
[picture p33: CAD file, 2024-12-05]
1-ECAD/cyberman/4-Library/3-3DModels/ICS-43434.stp
2.65 x 0.981 x 3.50 mm
