kodediy/kode-dot/1-ECAD/cyberman/4-Library/3-3DModels/MMDT2907A-7-F.stp

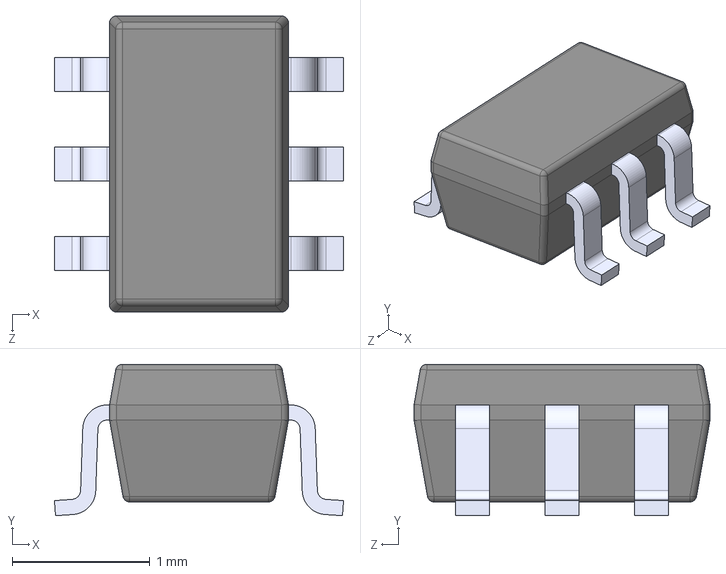
[picture p34: CAD file, 2024-12-05]
1-ECAD/cyberman/4-Library/3-3DModels/MMDT2907A-7-F.stp
2.10 x 1.10 x 2.15 mm
