kodediy/kode-dot/1-ECAD/cyberman/4-Library/3-3DModels/LSM6DSOTR.stp

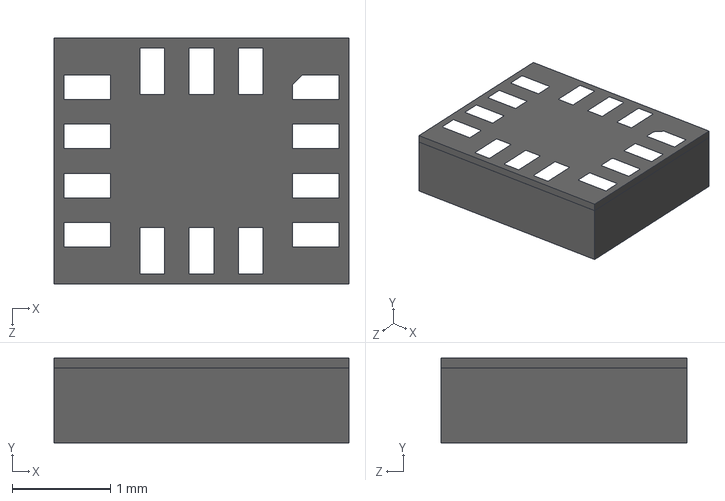
[picture p35: CAD file, 2024-12-05]
1-ECAD/cyberman/4-Library/3-3DModels/LSM6DSOTR.stp
3.00 x 0.86 x 2.50 mm
