kodediy/kode-dot/1-ECAD/cyberman/4-Library/3-3DModels/W25Q128JWPIQ.stp

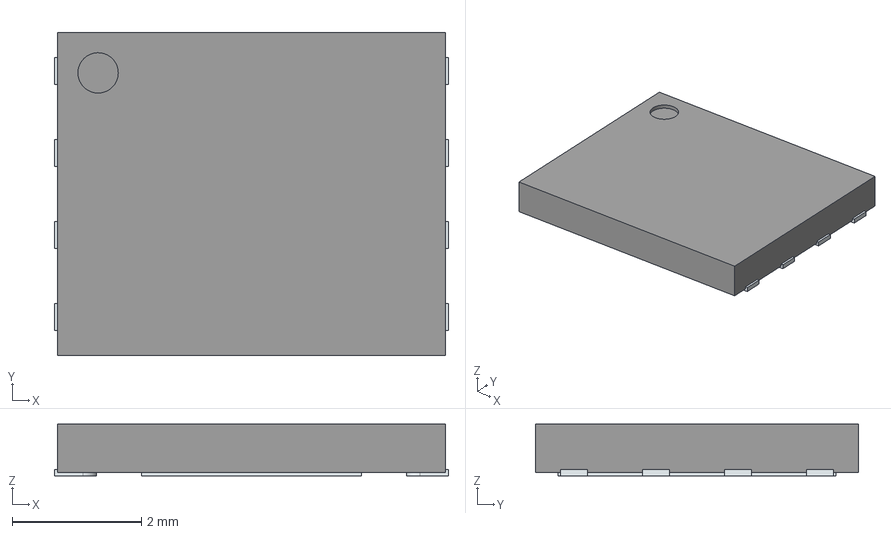
[picture p36: CAD file, 2024-12-05]
1-ECAD/cyberman/4-Library/3-3DModels/W25Q128JWPIQ.stp
6.10 x 5.00 x 0.8 mm
ThermalPin
PinsArrayLR
