kodediy/kode-dot/1-ECAD/cyberman/4-Library/3-3DModels/LM3281YFQR.stp

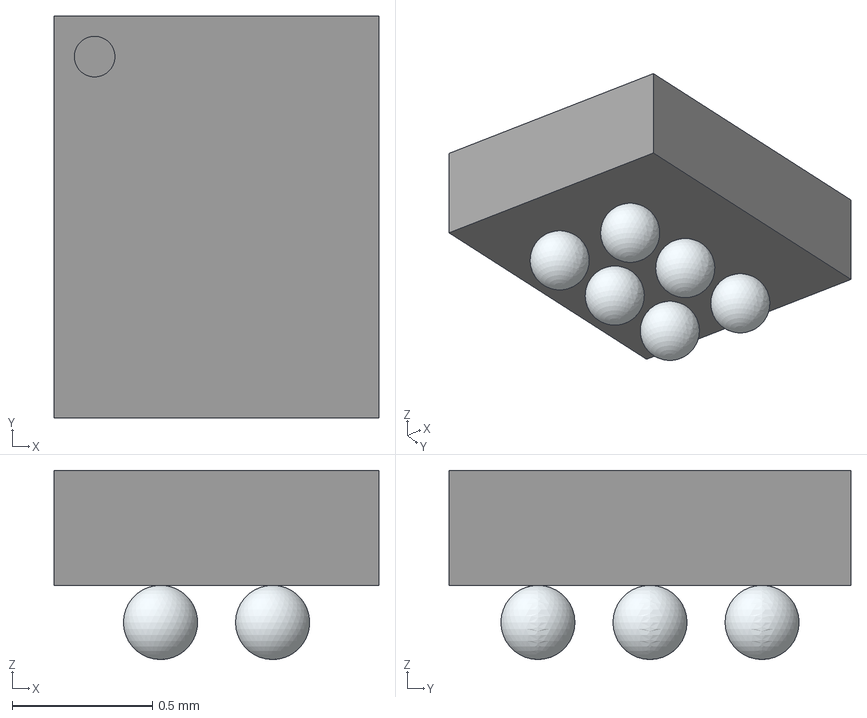
[picture p37: CAD file, 2024-12-05]
1-ECAD/cyberman/4-Library/3-3DModels/LM3281YFQR.stp
1.16 x 1.44 x 0.675 mm
