kodediy/kode-dot/1-ECAD/cyberman/4-Library/3-3DModels/DMP1045U-7.stp

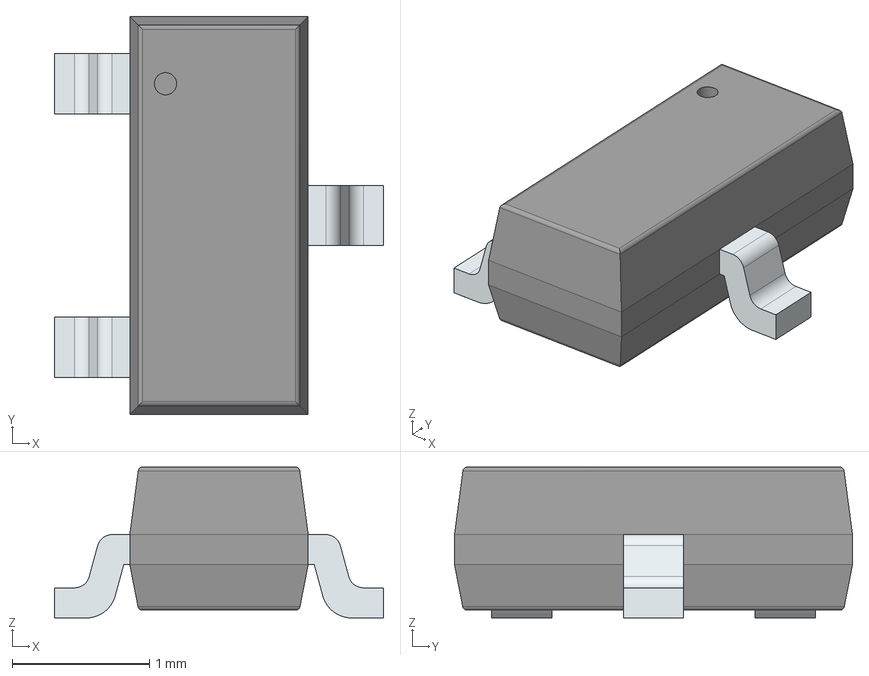
[picture p38: CAD file, 2024-12-05]
1-ECAD/cyberman/4-Library/3-3DModels/DMP1045U-7.stp
2.40 x 2.90 x 1.10 mm
PinsArrayL
FilletPinR
