kodediy/kode-dot/1-ECAD/cyberman/4-Library/3-3DModels/LIS2MDLTR.stp

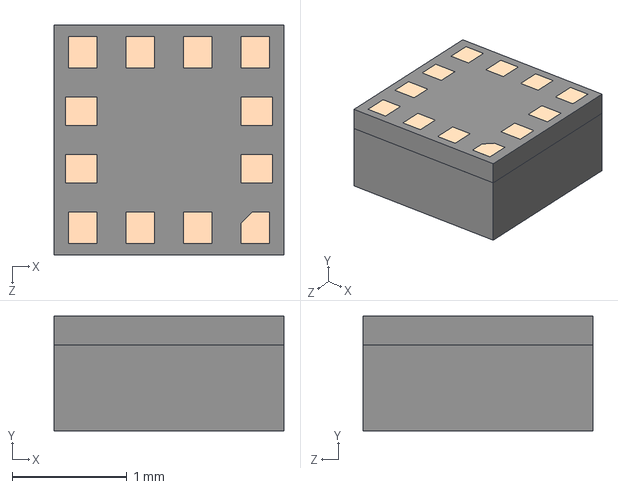
[picture p39: CAD file, 2024-12-05]
1-ECAD/cyberman/4-Library/3-3DModels/LIS2MDLTR.stp
2.00 x 1.00 x 2.00 mm
