kodediy/kode-dot/1-ECAD/cyberman/4-Library/3-3DModels/YXT-BB10-24S-02.stp

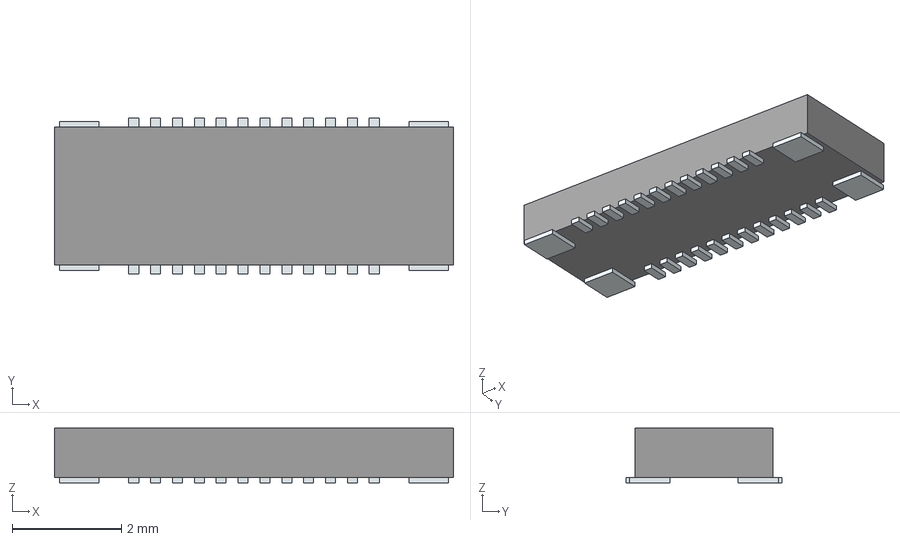
[picture p40: CAD file, 2024-12-05]
1-ECAD/cyberman/4-Library/3-3DModels/YXT-BB10-24S-02.stp
7.30 x 2.85 x 1.00 mm
Pins
