kodediy/kode-dot/1-ECAD/cyberman/4-Library/3-3DModels/ESP32-S3R16V.stp

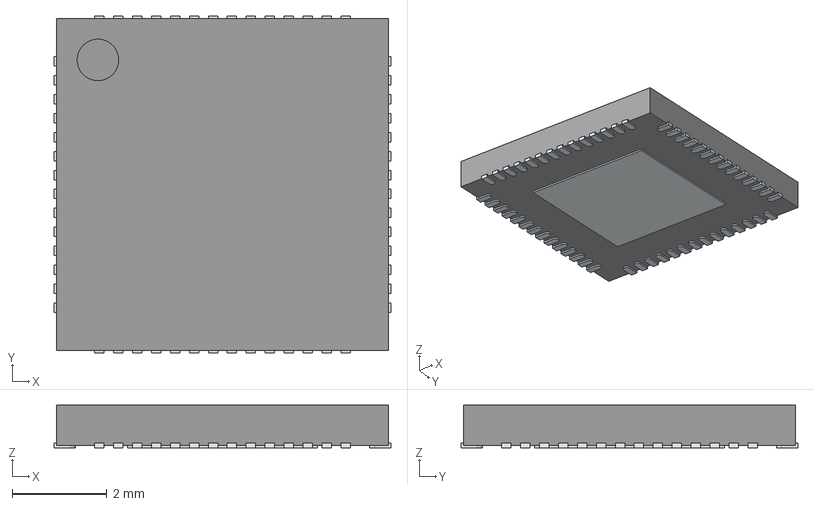
[picture p41: CAD file, 2024-12-02]
1-ECAD/cyberman/4-Library/3-3DModels/ESP32-S3R16V.stp
7.10 x 7.10 x 0.9 mm
ThermalPin
PinsArrayLR
PinsArrayTB
