kodediy/kode-dot/(list of files, cad)

Other CAD files:
1-ECAD/cyberman/2-Design/LCD/LCD-Drawing.dwg
1-ECAD/cyberman/4-Library/3-3DModels/1054500101.step
1-ECAD/cyberman/4-Library/3-3DModels/5033981892.stp
1-ECAD/cyberman/4-Library/3-3DModels/532610271.stp
1-ECAD/cyberman/4-Library/3-3DModels/BQ25896RTWR.stp
1-ECAD/cyberman/4-Library/3-3DModels/BQ27220YZFR.stp
1-ECAD/cyberman/4-Library/3-3DModels/DFE252012P-1R0M=P2.stp
1-ECAD/cyberman/4-Library/3-3DModels/MAX17048G+T10.step
1-ECAD/cyberman/4-Library/3-3DModels/MAX98357AETE+T.stp
1-ECAD/cyberman/4-Library/3-3DModels/MAX98361A.stp
3-CAD/MVP Mecanico v1.f3d
