kodediy/kode-dot/1-ECAD/cyberman/cyberman.kicad_pcb

## KiCad design 1-ECAD/cyberman/cyberman.kicad_pcb (2024-12-17)

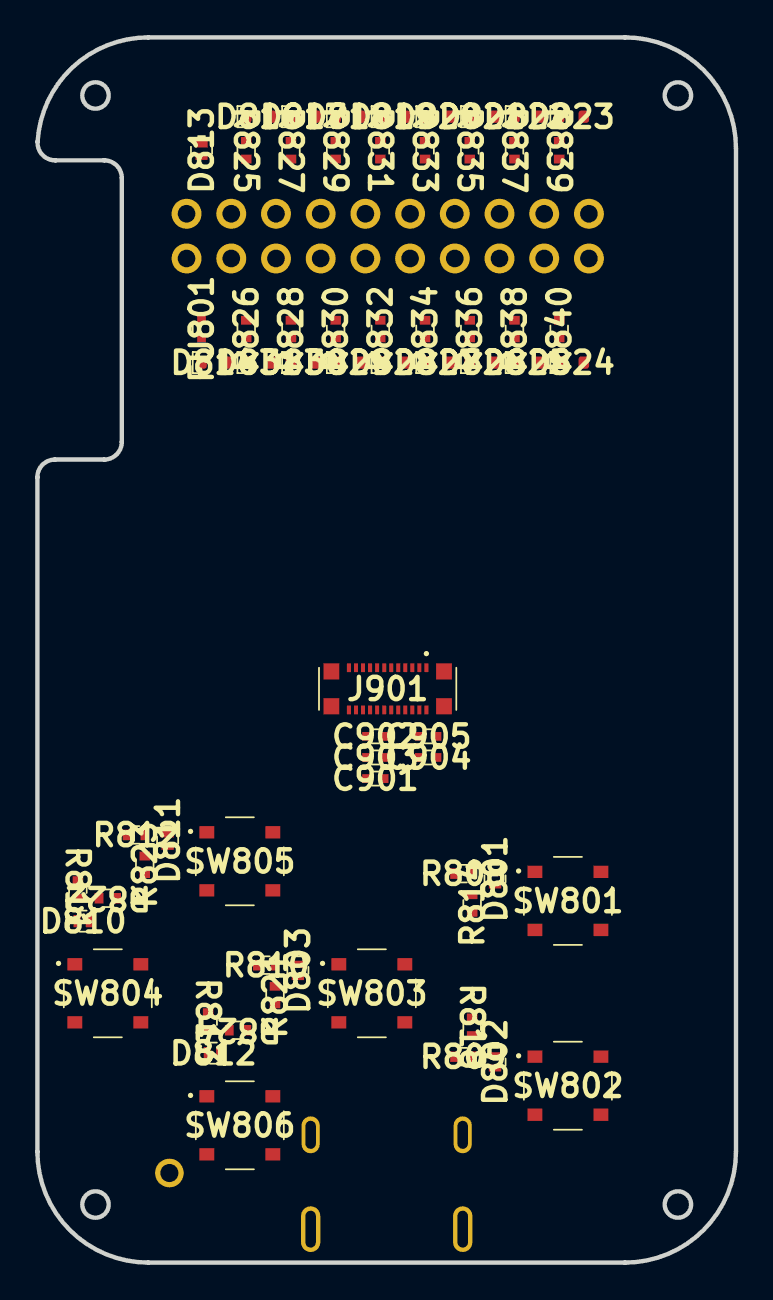
[picture p42: board cyberman.kicad_pcb from above]

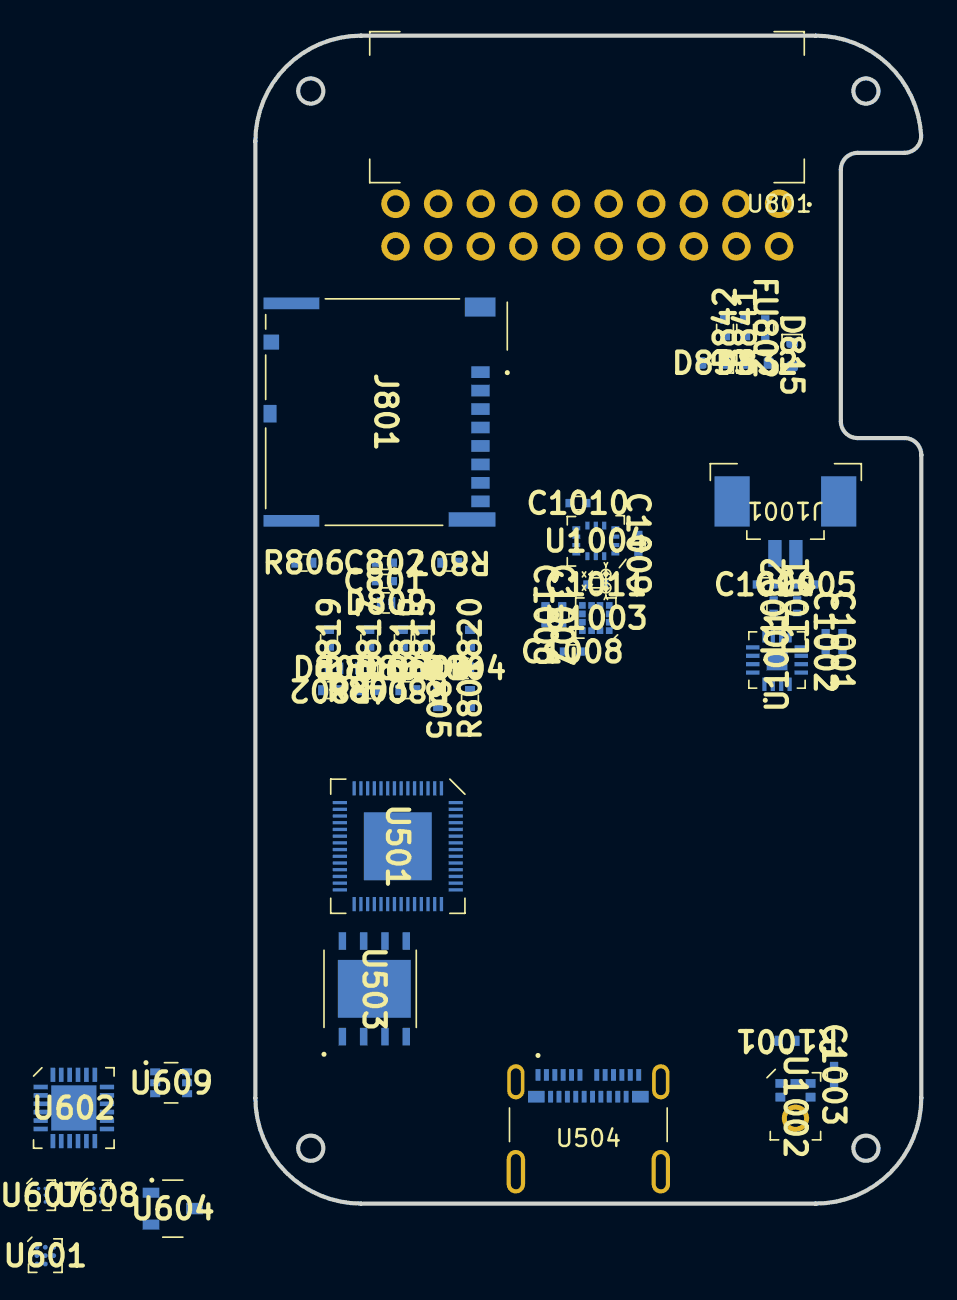
[picture p43: board cyberman.kicad_pcb from below]

Board: 4 copper layers, 39.7 x 69.6 mm, 121 parts (56 on the bottom side), 85 nets, no tracks yet.

Parts:
C801, C802, C901, C904, C1001, C1006: CC0402MRX5R6BB106; C_0402
C902, C903, C905, C1002, C1003, C1007, C1008, C1009, C1010: CC0402KRX7R8BB104; C_0402
C1004, C1005: CC0402KRX7R8BB221; C_0402
C1011: CC0402KRX5R8BB224; C_0402
D801, D802, D803, D804, D805, D806, D807, D808, D809, D810, D811, D812, D813: LESD8D3.3CAT5G
D814, D815, D816, D817, D818, D819, D820, D821, D822, D823, D824, D825, D826, D827, D828, D829, D830, D831, D832, D833: LESD5D5.0CT1G
FU801, FU802: ERBRD2R00X; ERBRD0R63X
J801: 5033981892
J901: YXT-BB10-24S-02
J1001: 532610271
L1001, L1002: BLM15PX331SZ1D
R801, R802, R803, R804, R805, R806, R807: RC0402FR-0747KL; R_0402
R808, R809, R810, R811, R812, R813: RC0402FR-0710KL; R_0402
R814, R818, R821, R822, R823, R824: RC0402FR-07330RL; R_0402
R815, R820: RC0402FR-07150RL; R_0402
R816, R817, R819, R825, R826, R827, R828, R829, R830, R831, R832, R833, R834, R835, R836, R837, R838, R839, R840, R841, R842: RC0402FR-0751RL; R_0402
R1001: RC0402FR-07100KL; R_0402
SW801, SW802, SW803, SW804, SW805, SW806: SKRMAAE010
U501: ESP32-S3R16V
U503: W25Q128JWPIQ
U504: 1054500101
U601: BQ27220YZFR
U602: BQ25896RTWR
U604: RS3221-3.3YF3
U607, U608: LM3281YFQR
U609: MMDT2907A-7-F
U801: PM254-2-10-W-8.5
U1001: MAX98357A; MAX98357AETE+T
U1002: ICS-43434
U1003: LIS2MDLTR
U1004: LSM6DSOTR

Connections:
+3V3: C1001.1, C1002.1, C1003.1, C1006.1, C1007.1, C1008.1, C1009.1, C1010.1, R808.1, R809.1, R810.1, R811.1, R812.1, R813.1, U608.A1 (FB), U1001.7 (VDD), U1001.8 (VDD), U1002.5 (VDD), U1003.3 (CS), U1003.9 (VDD), U1003.10 (VDDIO), U1004.1 (SDO/SA0), U1004.5 (VDDIO), U1004.8 (VDD), U1004.12 (CS)
+BATT: U601.C1 (SRP), U601.C3 (BAT)
/Project Architecture/Display/DSP.RST: J901.9 (RST), J901.21 (TP-RST)
/Project Architecture/MCU - IOs/BUTTON.BACK: R818.1, U501.37 (SPICLK_P)
/Project Architecture/MCU - IOs/BUTTON.SELECT: R814.1, U501.36 (SPICLK_N)
/Project Architecture/MCU - IOs/SD.CD: D804.1, R801.2, R820.1
/Project Architecture/MCU - IOs/SD.CLK: D806.1, R803.2, R817.1, U501.23 (GPIO17)
/Project Architecture/MCU - IOs/SD.CS: D808.1, R805.2, R815.1, U501.22 (XTAL_32K_N)
/Project Architecture/MCU - IOs/SD.MISO: D805.1, R802.2, R819.1, U501.27 (GPIO21)
/Project Architecture/MCU - IOs/SD.MOSI: D807.1, R804.2, R816.1, U501.24 (GPIO18)
/Project Architecture/MCU - IOs/SPICLK: U501.33 (SPICLK), U503.6 (CLK)
/Project Architecture/MCU - IOs/SPICS0: U501.32 (SPICS0), U503.1 (~CS)
/Project Architecture/MCU - IOs/SPID: U501.35 (SPID), U503.5 (DI(IO0))
/Project Architecture/MCU - IOs/SPIHD: U501.30 (SPIHD), U503.7 (IO3)
/Project Architecture/MCU - IOs/SPIQ: U501.34 (SPIQ), U503.2 (DO(IO1))
/Project Architecture/MCU - IOs/SPIWP: U501.31 (SPIWP), U503.3 (IO2)
/Project Architecture/Peripherals/1: D816.1, R825.1
/Project Architecture/Peripherals/2: D817.1, R827.1
/Project Architecture/Peripherals/3: D818.1, R829.1
/Project Architecture/Peripherals/4: D819.1, R831.1
/Project Architecture/Peripherals/5: D820.1, R833.1
/Project Architecture/Peripherals/6: D821.1, R835.1
/Project Architecture/Peripherals/7: D822.1, R837.1
/Project Architecture/Peripherals/8: D823.1, R839.1
/Project Architecture/Peripherals/9: D831.1, R826.1
/Project Architecture/Peripherals/10: D830.1, R828.1
/Project Architecture/Peripherals/11: D829.1, R830.1
/Project Architecture/Peripherals/12: D828.1, R832.1
/Project Architecture/Peripherals/13: D827.1, R834.1
/Project Architecture/Peripherals/14: D826.1, R836.1
/Project Architecture/Peripherals/15: D825.1, R838.1
/Project Architecture/Peripherals/16: D824.1, R840.1
/Project Architecture/Peripherals/BOARD_I2C.SCL: D832.1, R841.1
/Project Architecture/Peripherals/BOARD_I2C.SDA: D833.1, R842.1
/Project Architecture/Sensors and Audio/I2C_BOARD.SCL: U1003.1 (SCL/SPC), U1004.13 (SCL)
/Project Architecture/Sensors and Audio/I2C_BOARD.SDA: U1003.4 (SDA/SDI/SDO), U1004.14 (SDA)
/Project Architecture/Sensors and Audio/I2S.SCK: U1001.16 (BCLK), U1002.4 (SCK)
/Project Architecture/Sensors and Audio/I2S.SD: R1001.1, U1001.1 (DIN), U1002.6 (SD)
/Project Architecture/Sensors and Audio/I2S.WS: U1001.14 (LRCLK), U1002.1 (WS)
EXT_3V3: C801.1, C802.1, C901.1, C902.1, C903.1, C904.1, C905.1, D809.1, D813.2, J801.4 (VDD), J901.15 (VCC), J901.16 (VCI_EN), J901.17 (VBAT), J901.23 (TP-VDD), R801.1, R802.1, R803.1, R804.1, R805.1, R806.1, R807.1, U607.A1 (FB), U801.1
GND: C801.2, C802.2, C901.2, C902.2, C903.2, C904.2, C905.2, C1001.2, C1002.2, C1003.2, C1004.2, C1005.2, C1006.2, C1007.2, C1008.2, C1009.2, C1010.2, C1011.2, D801.2, D802.2, D803.2, D804.2, D805.2, D806.2, D807.2, D808.2, D809.2, D810.2, D811.2, D812.2, D813.1, D814.2, D815.2, D816.2, D817.2, D818.2, D819.2, D820.2, D821.2, D822.2, D823.2, D824.2, D825.2, D826.2, D827.2, D828.2, D829.2, D830.2, D831.2, D832.2, D833.2, J801.6 (VSS), J801.9 (VSS), J901.13 (GND), J901.18 (GND), J901.24 (GND), J901.P1 (SHELL), J901.P2 (SHELL), J901.P3 (SHELL), J901.P4 (SHELL), R1001.2, SW801.2, SW802.2, SW803.2, SW804.2, SW805.2, SW806.2, U503.4 (GND), U504.A1 (GND), U504.A12 (GND), U504.B1 (GND), U504.B12 (GND), U601.B2 (VSS), U602.9 (~CE), U602.17 (PGND), U602.18 (PGND), U604.1 (GND), U801.19, U801.20, U1001.3 (GND), U1001.11 (GND), U1001.15 (GND), U1001.17 (EP), U1002.2 (LR), U1002.3 (GND), U1003.6 (GND), U1003.8 (GND), U1004.2 (SDx), U1004.3 (SCx), U1004.6 (GND), U1004.7 (GND)
GNDPWR_EXT: U607.C2 (GND), U608.C2 (GND)
unnamed: U504.A6 (D+), U504.B6 (D+)
unnamed: U504.A7 (D-), U504.B7 (D-)
unnamed: U602.19 (SW), U602.20 (SW)
unnamed: D801.1, R808.2, R814.2, SW801.1
unnamed: D802.1, R809.2, R818.2, SW802.1
unnamed: D803.1, R810.2, R821.2, SW803.1
unnamed: D810.1, R811.2, R822.2, SW804.1
unnamed: D811.1, R812.2, R823.2, SW805.1
unnamed: D812.1, R813.2, R824.2, SW806.1
unnamed: FU801.2, U801.2
unnamed: J801.2 (CD/DAT3), R815.2
unnamed: J801.5 (CLK), R817.2
unnamed: J801.3 (CMD), R816.2
unnamed: J801.7 (DAT0), R819.2
unnamed: J801.8 (DAT1), R806.2
unnamed: J801.1 (DAT2), R807.2
unnamed: J801.10 (SW_DTCT), R820.2
unnamed: C1005.1, J1001.1, L1001.2
unnamed: C1004.1, J1001.2, L1002.2
unnamed: U609.2, U609.3, U609.5
unnamed: R825.2, U801.3
unnamed: R826.2, U801.4
unnamed: R827.2, U801.5
unnamed: R828.2, U801.6
unnamed: R829.2, U801.7
unnamed: R830.2, U801.8
unnamed: R831.2, U801.9
unnamed: R832.2, U801.10
unnamed: R833.2, U801.11
unnamed: R834.2, U801.12
unnamed: R835.2, U801.13
unnamed: R836.2, U801.14
unnamed: R837.2, U801.15
unnamed: R838.2, U801.16
unnamed: R839.2, U801.17
unnamed: R840.2, U801.18
unnamed: U601.C2 (SRN), U602.13 (BAT), U602.14 (BAT)
unnamed: L1002.1, U1001.10 (OUTN)
unnamed: L1001.1, U1001.9 (OUTP)
unnamed: C1011.1, U1003.5 (C1)
SYS: U602.15 (SYS), U602.16 (SYS), U607.A2 (VIN), U607.B1 (MODE), U608.A2 (VIN), U608.B1 (MODE), U608.C1 (EN)
VBUS: D814.1, D815.1, FU801.1, FU802.1, U602.1 (VBUS), U609.1
VUSB_5V: U504.A4 (VBUS), U504.A9 (VBUS), U504.B4 (VBUS), U504.B9 (VBUS), U609.4
