kodediy/kode-dot/1-ECAD/cyberman/2-Design/LCD/Touch_Driver/CST816D_T_820_Apollo/capacitive_hynitron_cst8xx_update.h

/*
*Name        : capacitive_hynitron_cst8xx_update.h
*Author      : gary
*Version     : V1.0
*Copyright   : Hynitron
*ProjectName : CSW_2000001_CST816T_SDK.hex       Modify at 2021-04-06 17:28:57
*/

#ifndef CAPACITIVE_HYNITRON_CST8XX_UPDATE_H__
#define CAPACITIVE_HYNITRON_CST8XX_UPDATE_H__

static unsigned char app_bin[] = {
0x00, 0x00, 0x00, 0x3c, 0xde, 0x60,
0x02, 0x34, 0x73, 0x7f, 0x00, 0x22, 0x02, 0x30, 0x45, 0x22, 0x00, 0x00, 0x02, 0x1f, 0xe9, 0x02, 
0x2e, 0xb8, 0xef, 0x24, 0xfc, 0x70, 0x05, 0x7e, 0x36, 0x7f, 0x01, 0x22, 0xe4, 0xfe, 0xff, 0x22, 
0x00, 0x02, 0x32, 0x00, 0xe5, 0x09, 0x24, 0x05, 0x12, 0x19, 0xd4, 0xe0, 0x70, 0x03, 0x02, 0x07, 
0x58, 0x12, 0x1a, 0x1c, 0x74, 0x20, 0x93, 0xff, 0xe5, 0x09, 0x24, 0x09, 0x12, 0x19, 0xd4, 0xe0, 
0xc3, 0x9f, 0x50, 0x65, 0xe5, 0x09, 0x24, 0x07, 0x12, 0x19, 0xd4, 0xe0, 0x54, 0xfe, 0xf0, 0xe5, 
0x09, 0x24, 0x11, 0x12, 0x19, 0xd4, 0xe4, 0xf0, 0xa3, 0xf0, 0xe5, 0x09, 0x24, 0x13, 0x12, 0x19, 
0xd4, 0xe4, 0xf0, 0x12, 0x19, 0xdf, 0x12, 0x1a, 0x8f, 0x24, 0x1b, 0x12, 0x19, 0xd4, 0x12, 0x19, 
0xdc, 0x12, 0x1a, 0x8d, 0x24, 0x1d, 0x12, 0x19, 0x9a, 0x12, 0x19, 0xdc, 0x12, 0x1a, 0x8f, 0x24, 
0x15, 0x12, 0x19, 0xd4, 0x12, 0x19, 0xdc, 0x12, 0x1a, 0x8d, 0x24, 0x17, 0x12, 0x19, 0xd4, 0x12, 
0x1b, 0x96, 0x24, 0x09, 0x12, 0x19, 0xd4, 0xe0, 0x60, 0x03, 0x02, 0x01, 0xec, 0xe5, 0x09, 0x24, 
0x05, 0x12, 0x19, 0xd4, 0xe4, 0xf0, 0x02, 0x01, 0xec, 0xe5, 0x09, 0x24, 0x07, 0x12, 0x19, 0xd4, 
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
0xc3, 0xe5, 0x24, 0x94, 0x01, 0xe5, 0x23, 0x64, 0x80, 0x94, 0x80, 0x50, 0x08, 0x75, 0x23, 0x00, 
0x75, 0x24, 0x01, 0x80, 0x1d, 0x12, 0x1a, 0x1c, 0x74, 0x01, 0x93, 0xfe, 0x74, 0x02, 0x93, 0xff, 
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
};

#endif /*CAPACITIVE_HYNITRON_CST8XX_UPDATE_H__*/
