kodediy/kode-dot/(commit log)

2024-10-30 add things
    [Block Diagram.kicad_sch, Power - Sequencing.kicad_sch, Project Architecture.kicad_sch, Revision History.kicad_sch, Section A - Title A.kicad_sch, Section B - TItle B.kicad_sch, kode_Hierarchical.kicad_pcb, kode_Hierarchical.kicad_sch]
2024-10-30 Create project
    [Block Diagram.kicad_sch, Power - Sequencing.kicad_sch, Project Architecture.kicad_sch, Revision History.kicad_sch, Section A - Title A.kicad_sch, Section B - TItle B.kicad_sch, cyberman.kicad_pcb, cyberman.kicad_sch]
2024-10-30 Version demo inicial de la web para el sistema operativo. Codigo ejemplo de arduino. Carpeta ConfiguracionesBoard con las configuraciones para cargar desde mac usando arduino
    [100ask-openjtag.cfg, 8devices-lima.cfg, actux3.cfg, adapteva_parallella1.cfg, adsp-sc584-ezbrd.cfg, advantech_imx8qm_dmsse20.cfg, alphascale_asm9260_ek.cfg, altera-10m50.cfg]
2024-10-31 add esp32 library
    [cyberman.kicad_pcb]
2024-11-02 Carpeta para archivos mecanicos
2024-11-02 Eliminados archivos .DS_Store del índice de Git
2024-11-04 esp32 supply
    [Power - Sequencing.kicad_sch, Project Architecture.kicad_sch, Section A - Title A.kicad_sch, Section B - TItle B.kicad_sch, cyberman.kicad_sch]
2024-11-05 update power sche
    [MCU-IOs.kicad_sch, MCU-Power.kicad_sch, cyberman.kicad_sch]
2024-11-19 esp32 hard guidelines
2024-11-19 microSD and LCD connector
    [LCD-Drawing.dwg, LCD_display.kicad_sch, MCU-IOs.kicad_sch, MCU-Power.kicad_sch, Project Architecture.kicad_sch, peripherals.kicad_sch, power.kicad_sch]
2024-11-22 add sensor page
    [Project Architecture.kicad_sch, power.kicad_sch, sensors.kicad_sch]
2024-11-22 add mic and speaker
    [LCD_display.kicad_sch, MCU-IOs.kicad_sch, peripherals.kicad_sch, sensors.kicad_sch]
2024-11-23 add bus and display connection
    [LCD_display.kicad_sch, MCU-IOs.kicad_sch, Project Architecture.kicad_sch, sensors.kicad_sch]
2024-12-02 esp and usbc footprints
    [1054500101.step, ESP32-S3R16V.stp, MCU-IOs.kicad_sch, MCU-Power.kicad_sch, peripherals.kicad_sch]
2024-12-03 add expander io and pic
    [MCU-IOs.kicad_sch, peripherals.kicad_sch, pic.kicad_sch, sensors.kicad_sch]
2024-12-05 add new footprints
    [5033981892.stp, BQ25896RTWR.stp, BQ27220YZFR.stp, DMP1045U-7.stp, ICS-43434.stp, LIS2MDLTR.stp, LM3281YFQR.stp, LSM6DSOTR.stp]
2024-12-09 footpritn day
    [0402_inductor.stp, 532610271.stp, LCD_display.kicad_sch, MAX98357AETE+T.stp, MCU-IOs.kicad_sch, MCU-Power.kicad_sch, PM254-2-10-W-8.5.step, cyberman.kicad_pcb]
2024-12-10 sensor page closed
    [0402_capacitor.stp, 0402_resistor.stp, cyberman.kicad_pcb, peripherals.kicad_sch, sensors.kicad_sch]
2024-12-10 add buttons
    [SKRMAAE010.STEP, cyberman.kicad_pcb, peripherals.kicad_sch]
2024-12-11 new changes
    close display page and peripheral schematic
    [Block Diagram.kicad_sch, LCD_display.kicad_sch, LESD5D5.0CT1G.stp, LESD8D3.3CAT5G.stp, MCU-IOs.kicad_sch, MCU-Power.kicad_sch, Project Architecture.kicad_sch, Revision History.kicad_sch]
2024-12-14 add fuse and place external connector
    [ERBRD2R00X.stp, cyberman.kicad_pcb, peripherals.kicad_sch]
2024-12-16 change layout
    [cyberman.kicad_pcb, peripherals.kicad_sch, power.kicad_sch]
2024-12-17 edit power page
    [S3B-ZR-SM4A-TF.STEP, TPS6282x.stp, power.kicad_sch]
2024-12-17 power page almost done
    [DMN313DLT-7.stp, power.kicad_sch]
2024-12-18 new footprints
    [power.kicad_sch]
2024-12-18 power page close
    siuuuuuuuuuuuu
    [Block Diagram.kicad_sch, DFE252012P-1R0M=P2.stp, LQM2MPNR47MGHL.stp, MCU-IOs.kicad_sch, MCU-Power.kicad_sch, MLP2012HR47MT0S1.stp, Project Architecture.kicad_sch, Revision History.kicad_sch]
