kodediy/kode-dot/(notices)

Notices in the files:
1-ECAD/cyberman/4-Library/3-3DModels/PM254-2-10-W-8.5.step:
Copyright (C) 2017, Terje Io
This work is licensed under the Creative Commons CC-BY-SA 4.0 License with the following exception:
To the extent that the creation of electronic designs that use 'Licensed Material'
https://creativecommons.org/licenses/by-sa/4.0/legalcode
